dylandibeneditto/bt-lora-transciever/README.md

# bt-lora-transciever

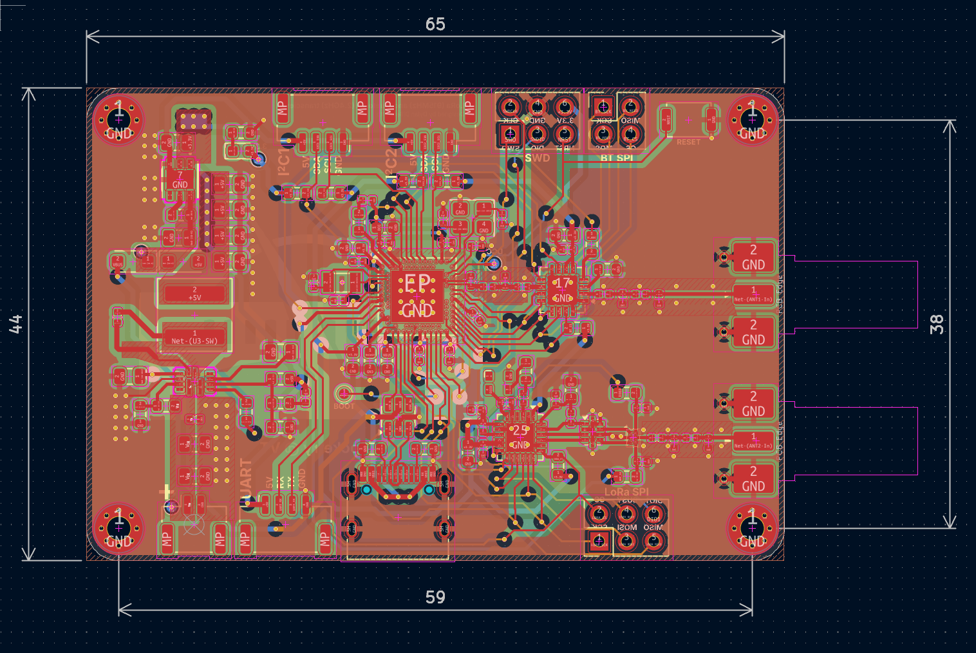
[picture p1: Layout.png]
layout

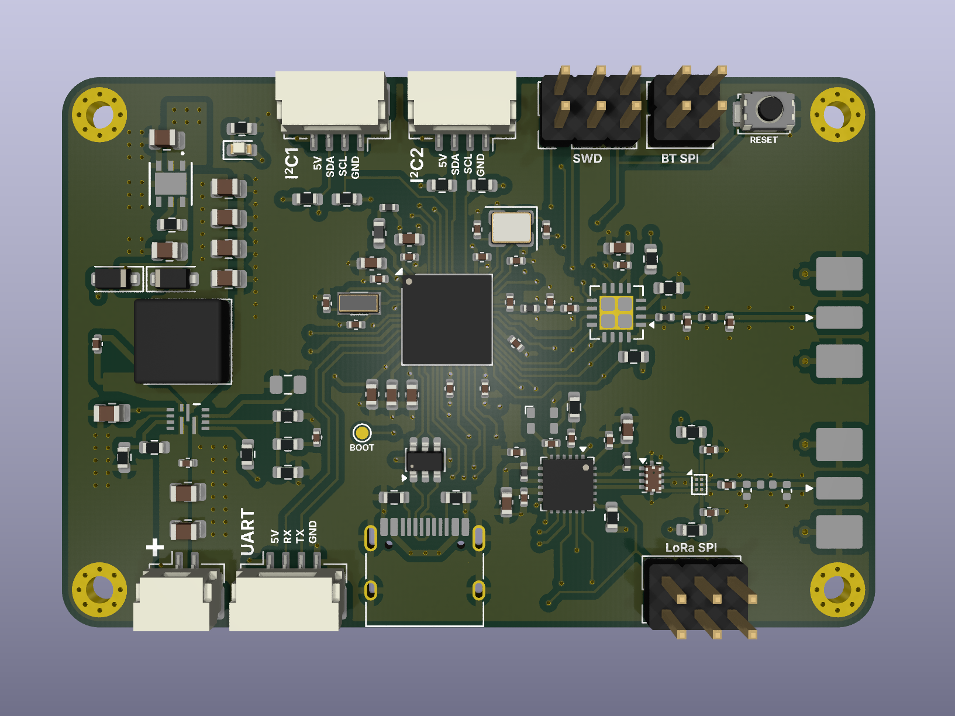
[picture p2: Front_3D.png]
Front 3D

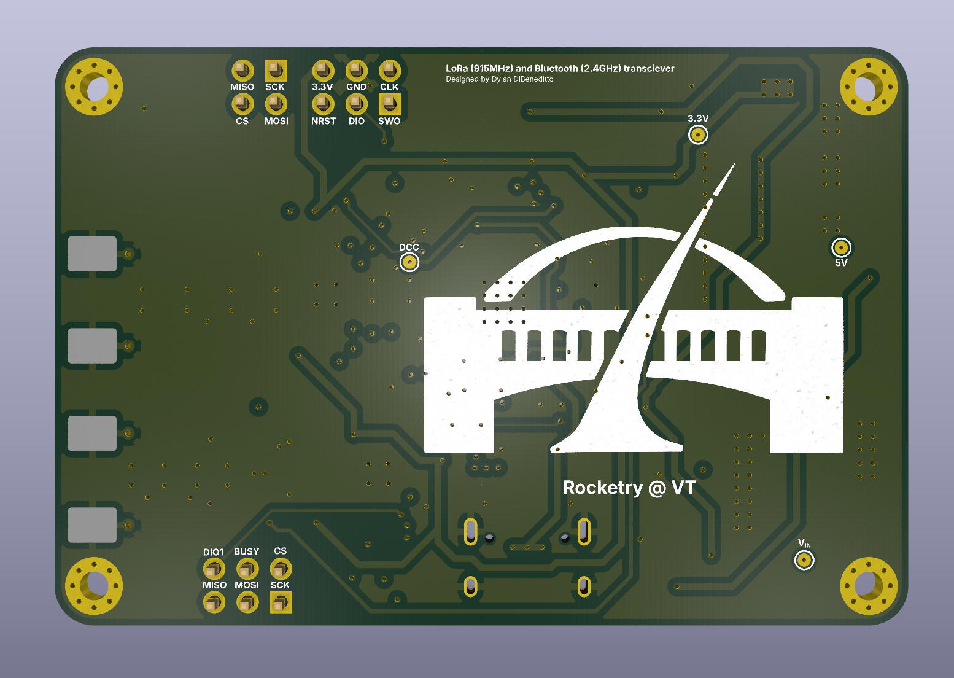
[picture p3: Back_3D.png]
Back 3D


## SX1262 (LoRa)
(datasheet)
https://semtech.my.salesforce.com/sfc/p/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
(application notes)
https://cdn-reichelt.de/documents/datenblatt/A200/SX1262REFERENCE.pdf

## Matching Network IC (0900FM15K0039001E)
https://www.johansontechnology.com/docs/1646/0900FM15K0039001E_rIWs6SY.pdf
https://www.johansontechnology.com/docs/2424/oldjti-an100_kC6DtU1.pdf

## nRF21540 (Bluetooth Range Extender)
https://docs.nordicsemi.com/r/bundle/ps_nrf21540/page/chapters/hw_layout/reference_circuitry/doc/alt1.html

## nRF52840
https://docs.nordicsemi.com/r/bundle/ps_nrf52840/page/keyfeatures_html5.html

## 3.3V LDO (LD39200)
https://www.st.com/content/ccc/resource/technical/document/datasheet/4b/e6/2e/a4/16/04/46/9d/DM00102135.pdf/files/DM00102135.pdf/jcr:content/translations/en.DM001021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

## 5V Buck (TPS51386)
https://www.ti.com/lit/ds/symlink/tps51386.pdf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

## TCXO (ECS-TXO-20SCMV4)
https://ecsxtal.com/store/pdf/ECS-TXO-20CSMV4.pdf
