dylandibeneditto/bt-lora-transciever/Reference Docs/nrf52840_qiaa_config5_schematic_REFERENCE.pdf

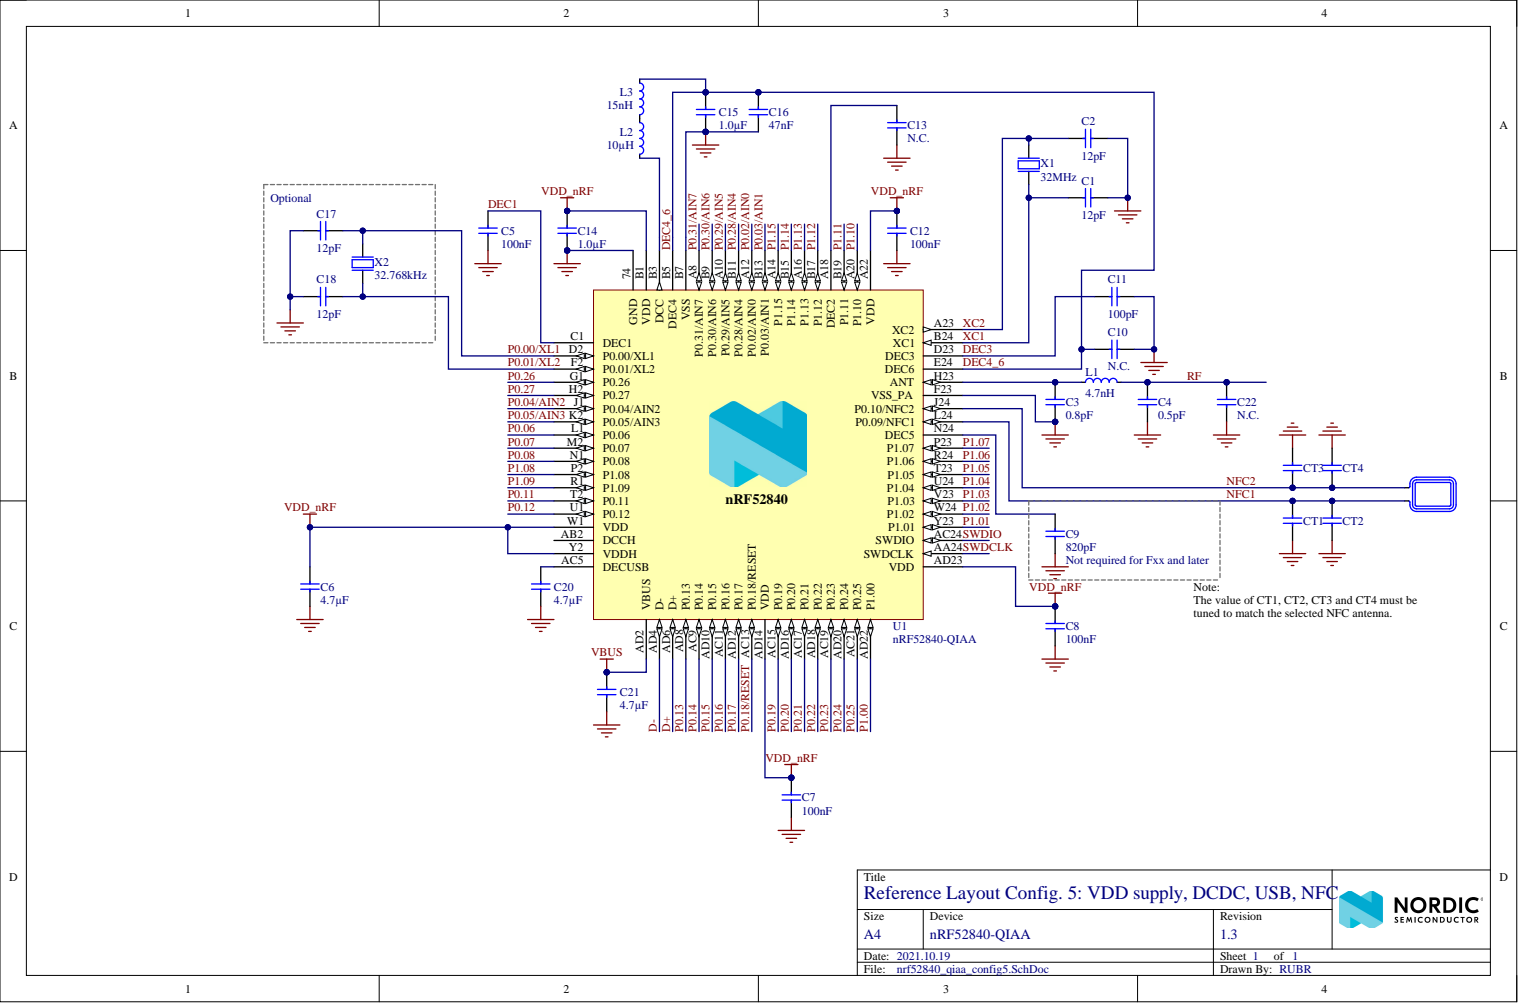
[picture p4: page 1]

Not required for Fxx and later

Note:
The value of CT1, CT2, CT3 and CT4 must be
tuned to match the selected NFC antenna.

Title
Reference Layout Config. 5: VDD supply, DCDC, USB, NFC
