dylandibeneditto/bt-lora-transciever/Reference Docs/nrf21540_EK_Schematic_And_PCB_REFERENCE.pdf

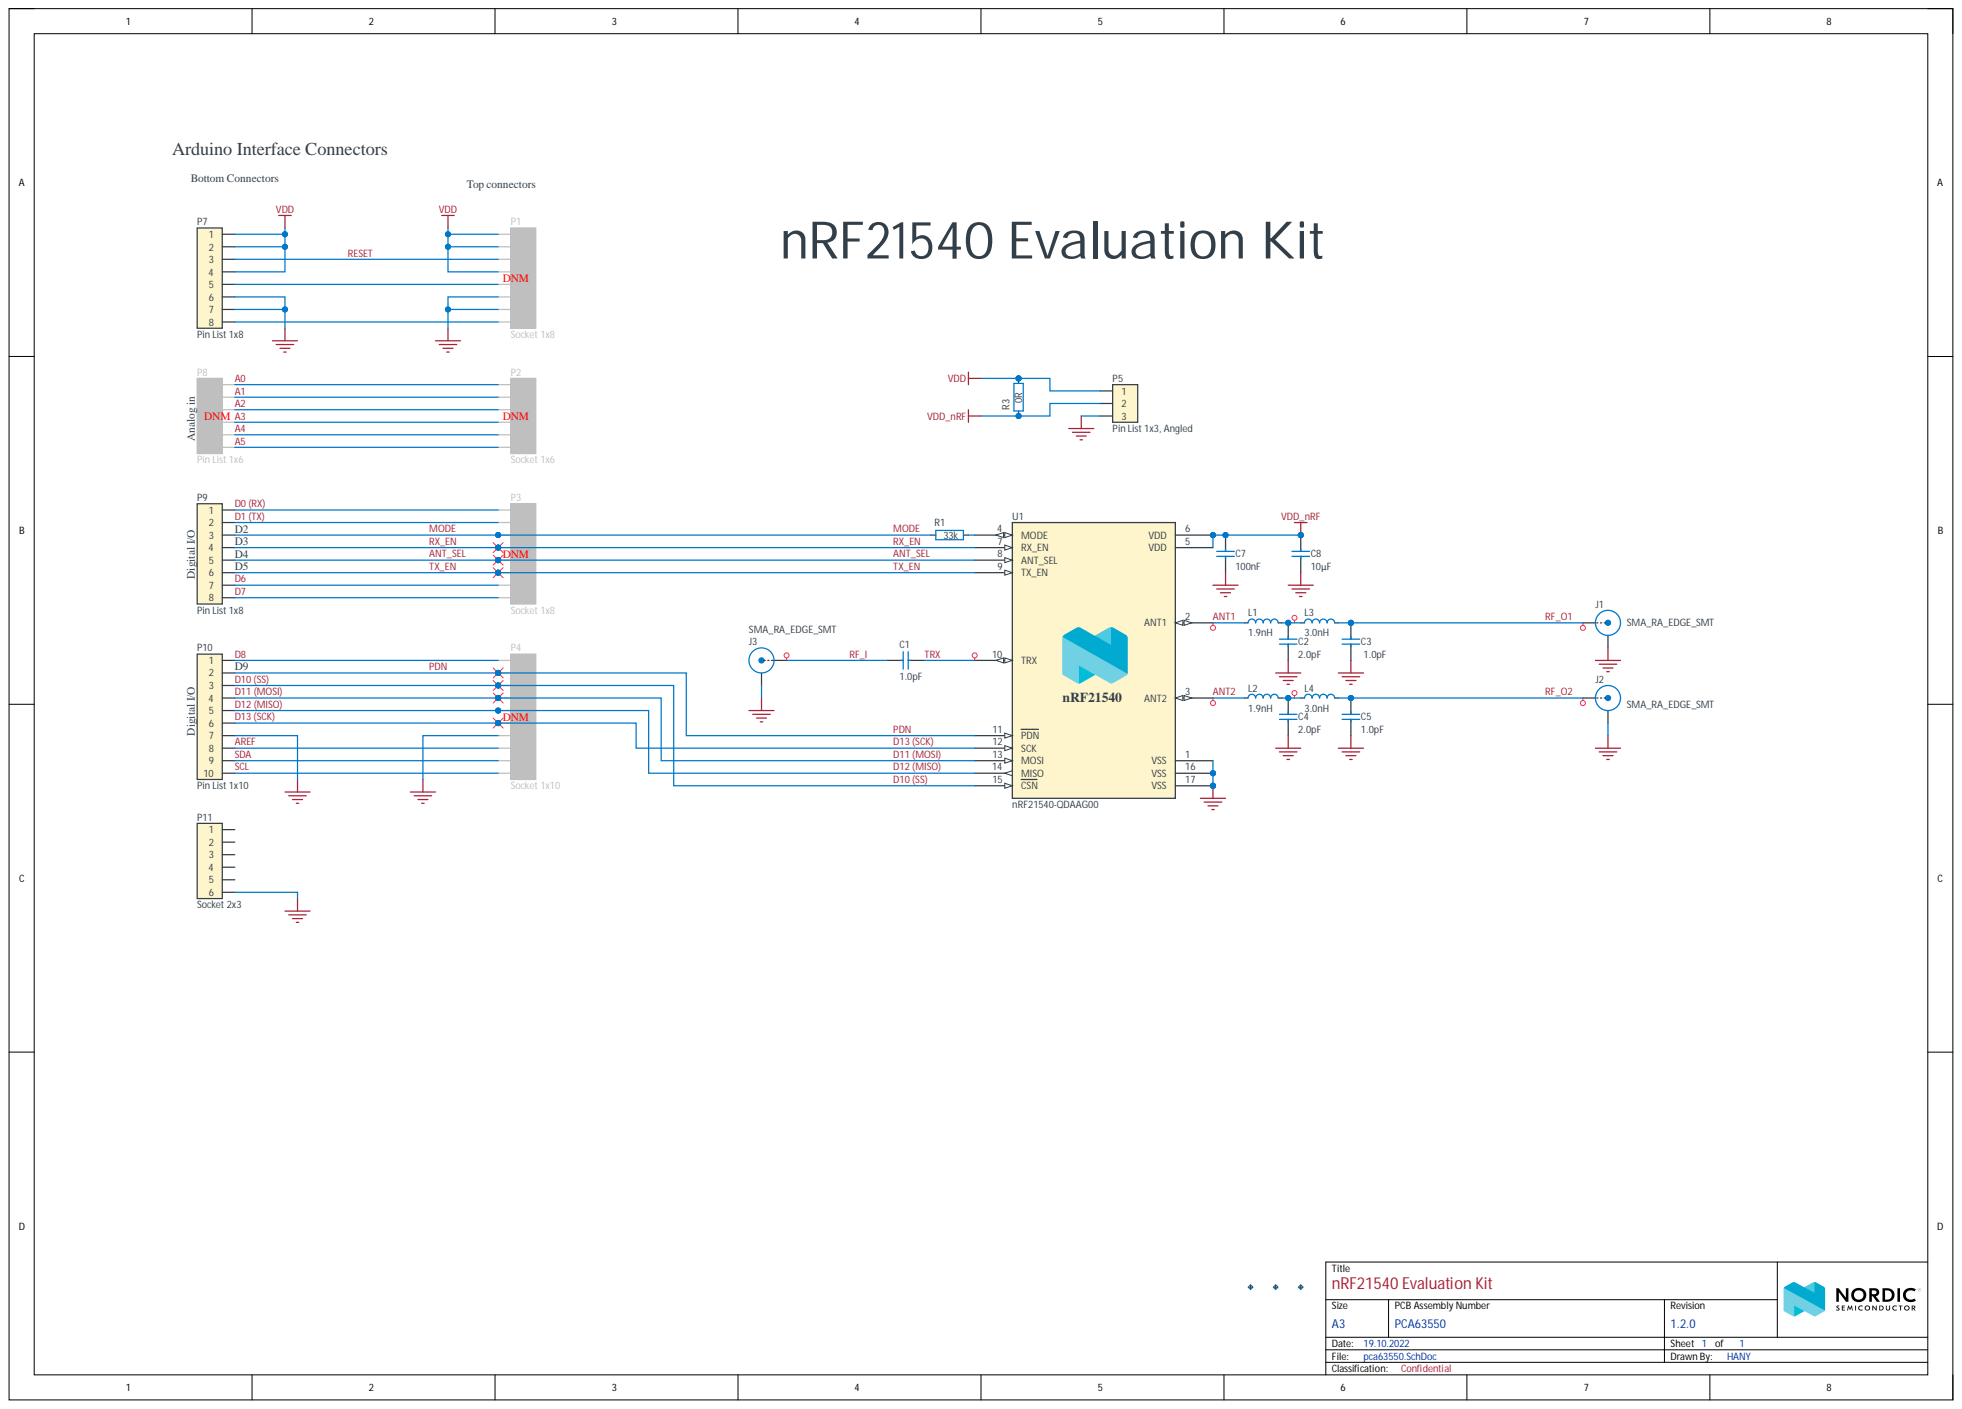
[picture p11: page 1]

Analog in Digital I/O Digital I/O

D4 ANT_SEL DNM | 5 | ANT_SEL | ANT_SEL 8
D5 TX_EN | 6 | TX_EN | TX_EN 9
D6 | 7 8 | | TRX 10

D10 (SS) | 3 | | 1.0pF
D11 (MOSI) | 4
D12 (MISO) | 5
D13 (SCK) DNM | 6
AREF | | | | 7 8 | D13 (SCK) | SCK 12
SDA | | | | 9 | D11 (MOSI) | MOSI 13

PDN

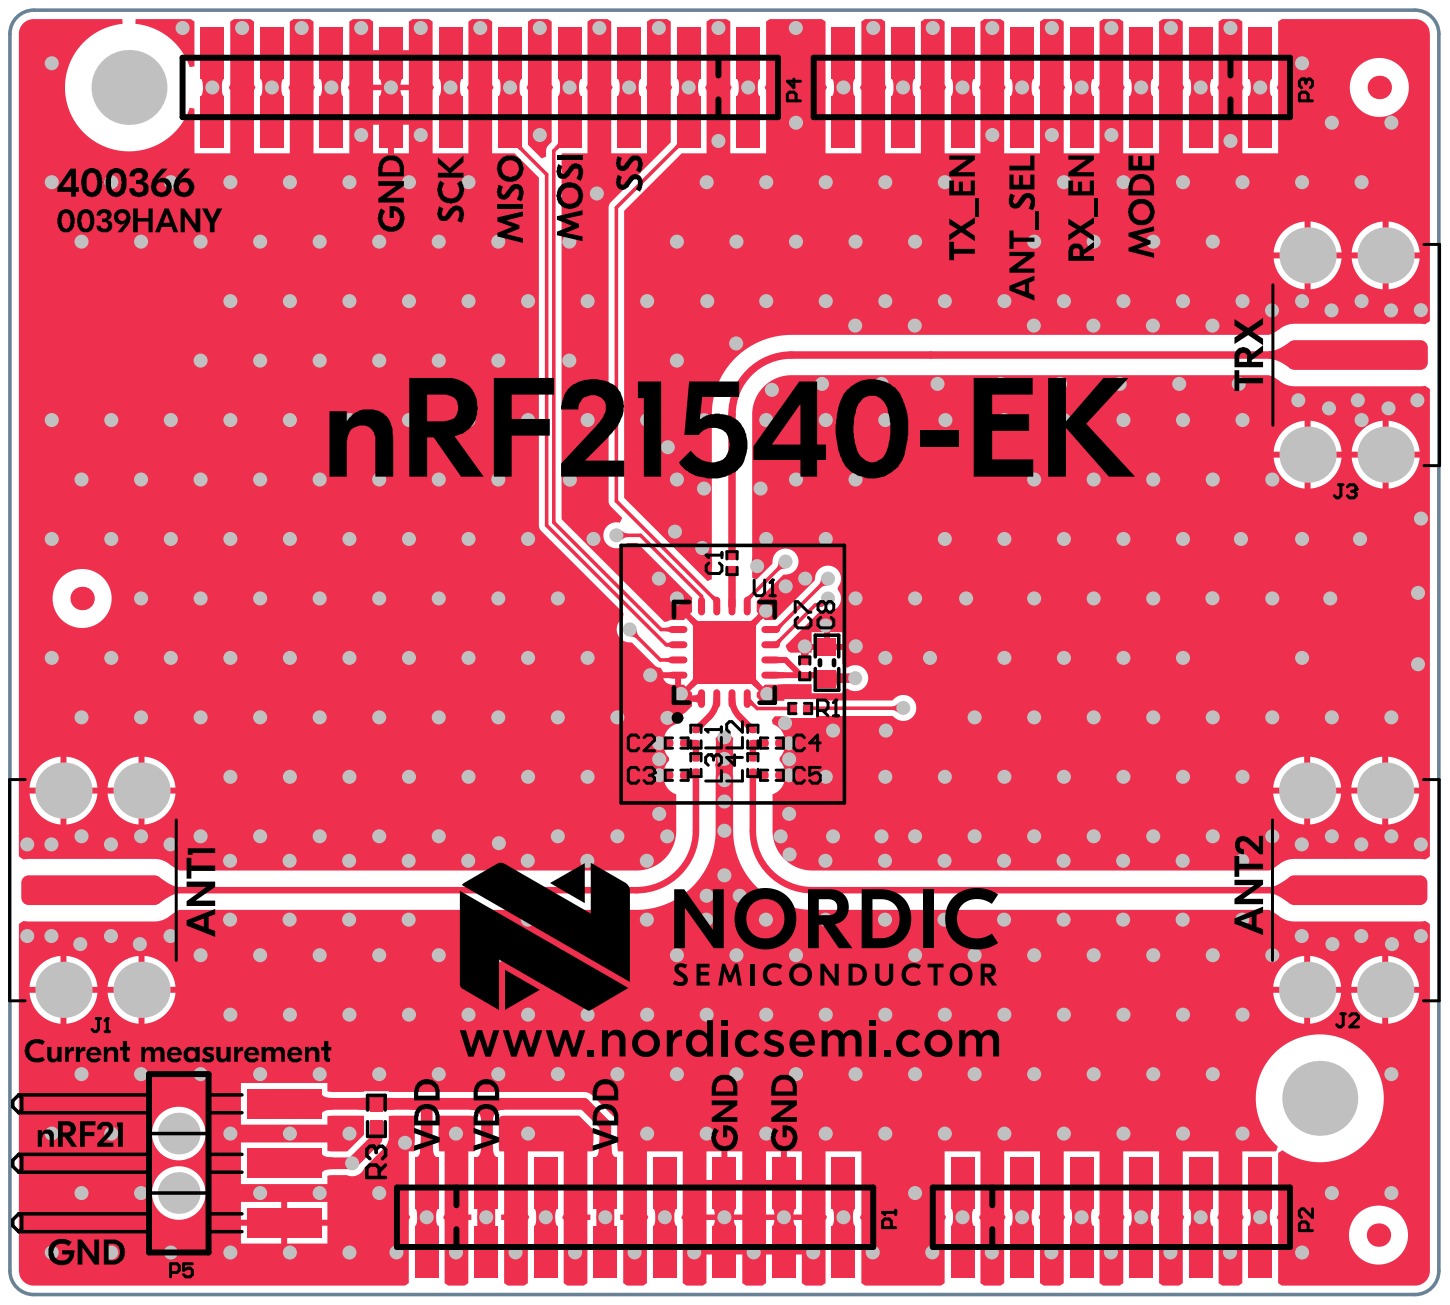
[picture p12: page 2]

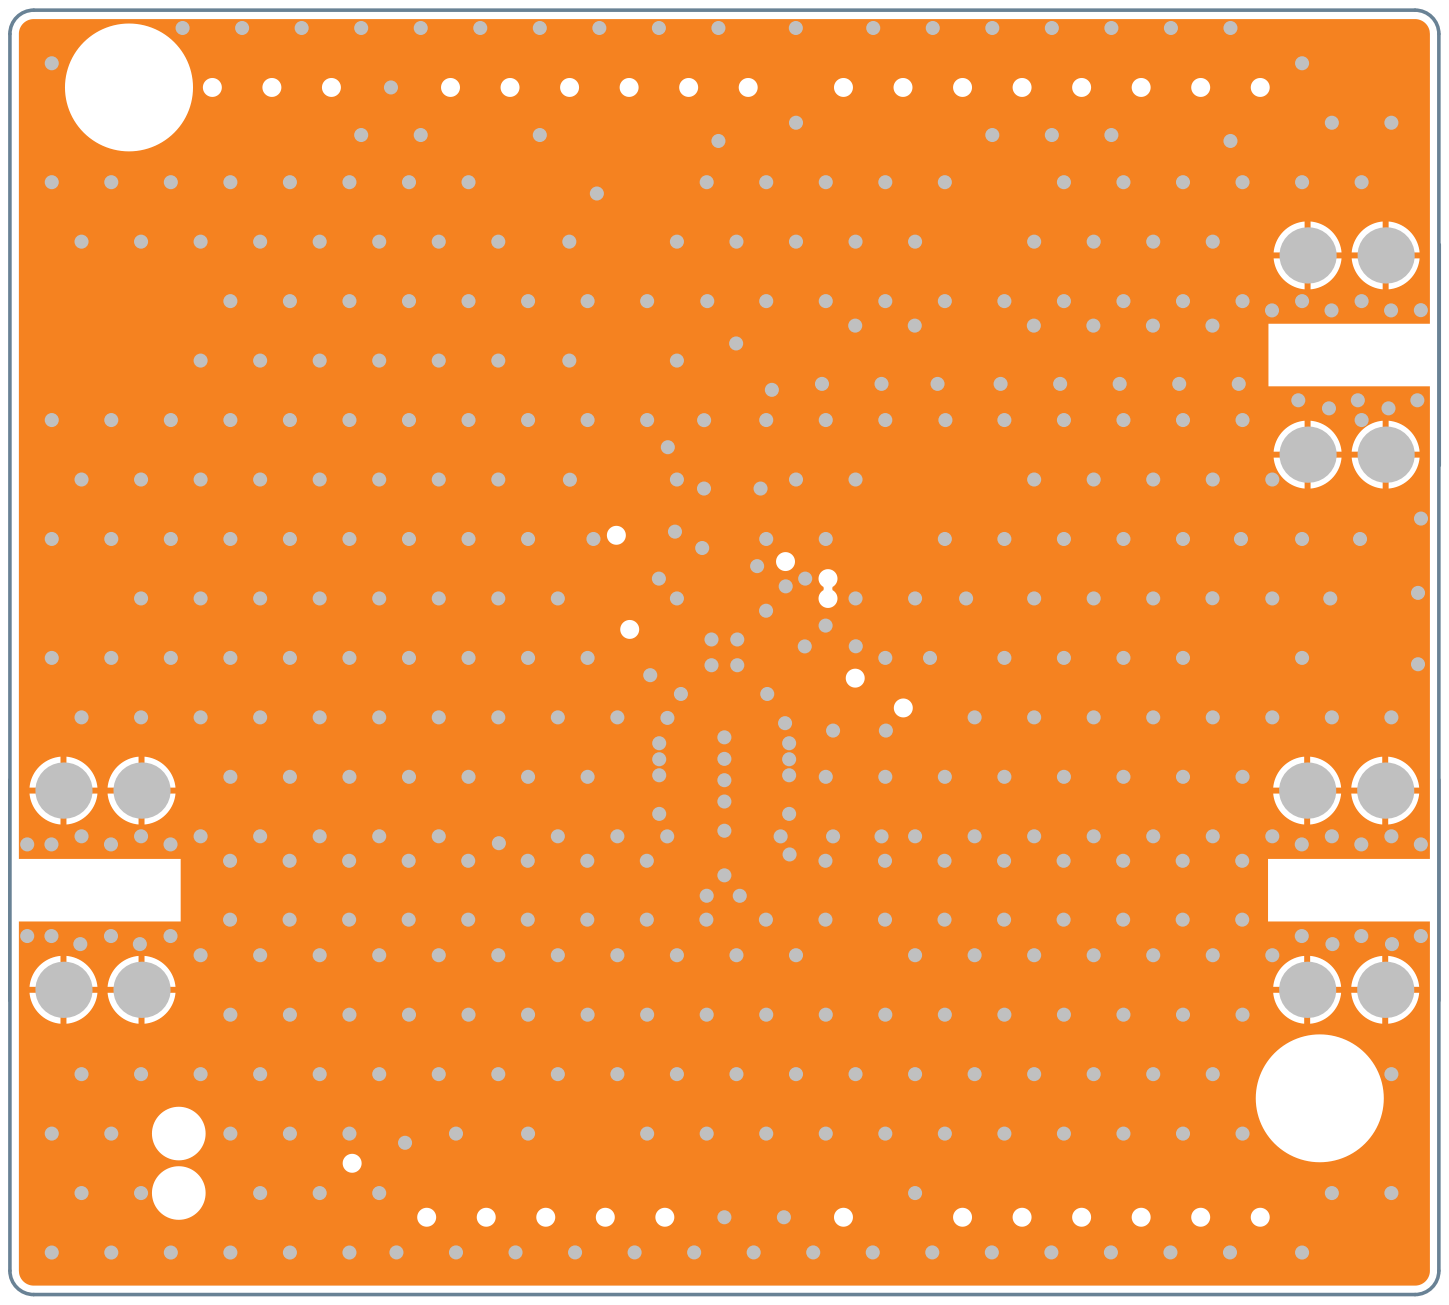
[picture p13: page 3]

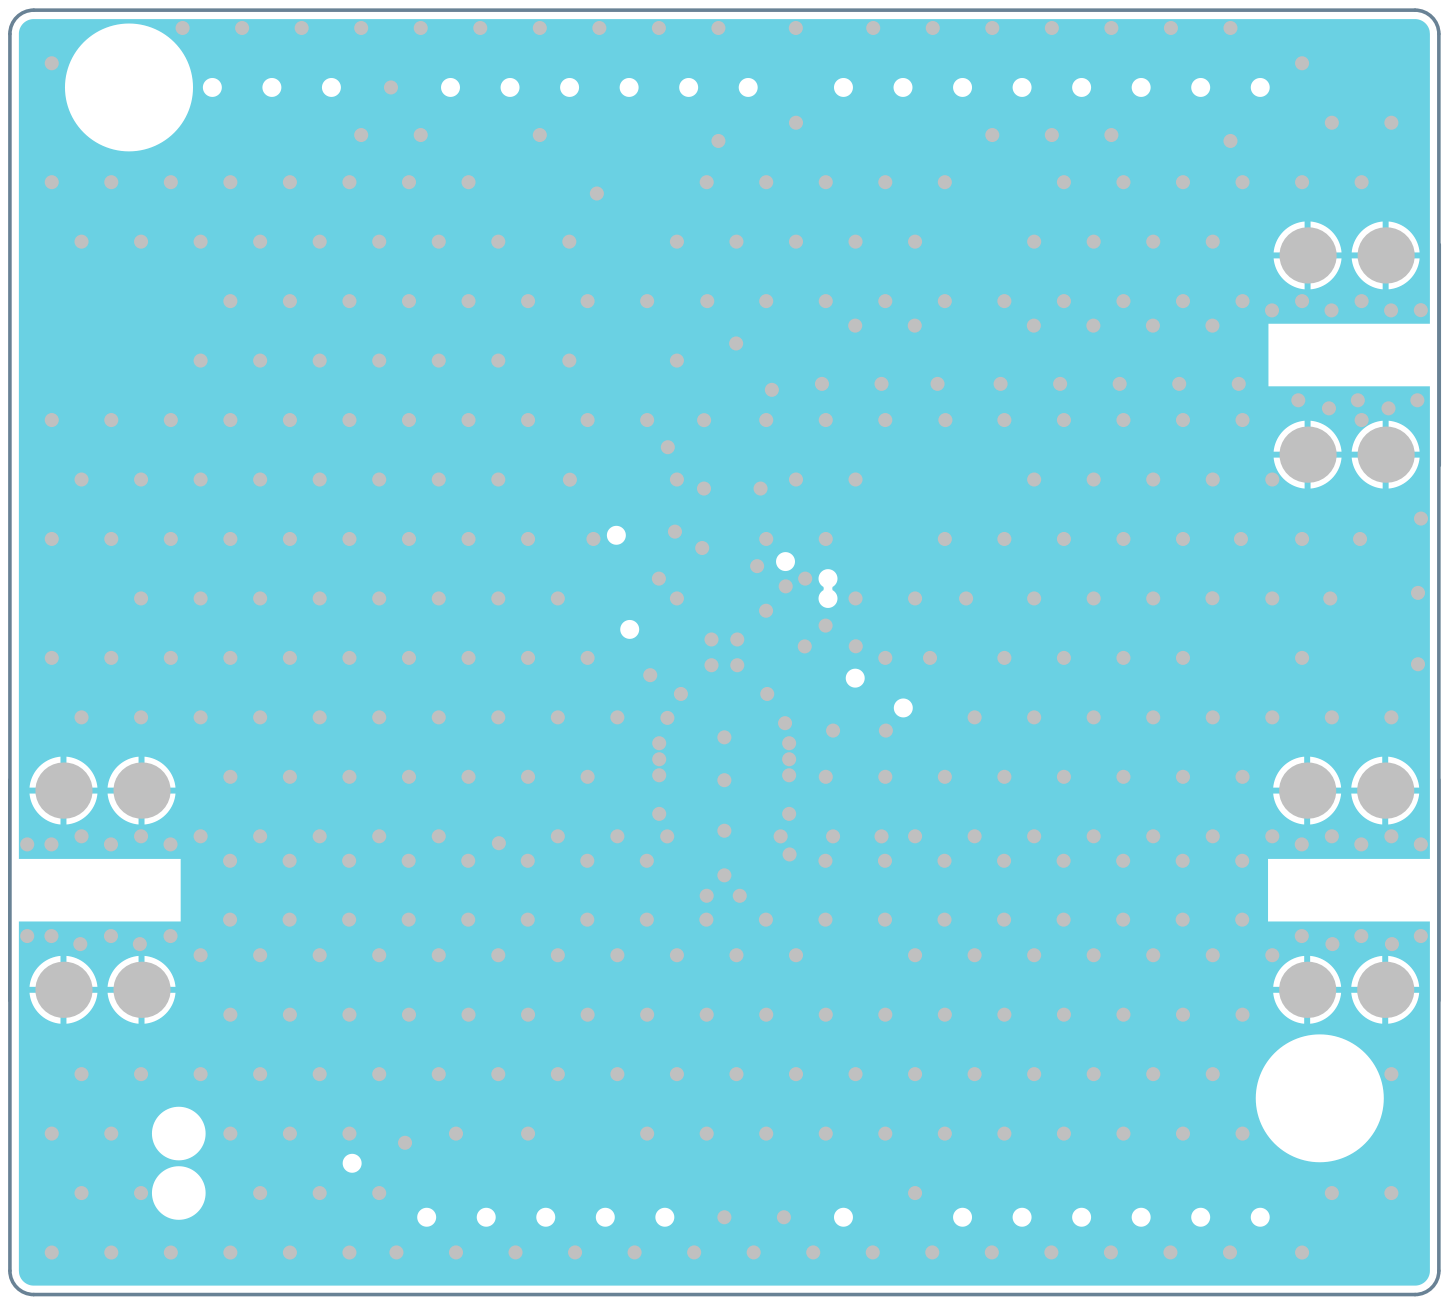
[picture p14: page 4]

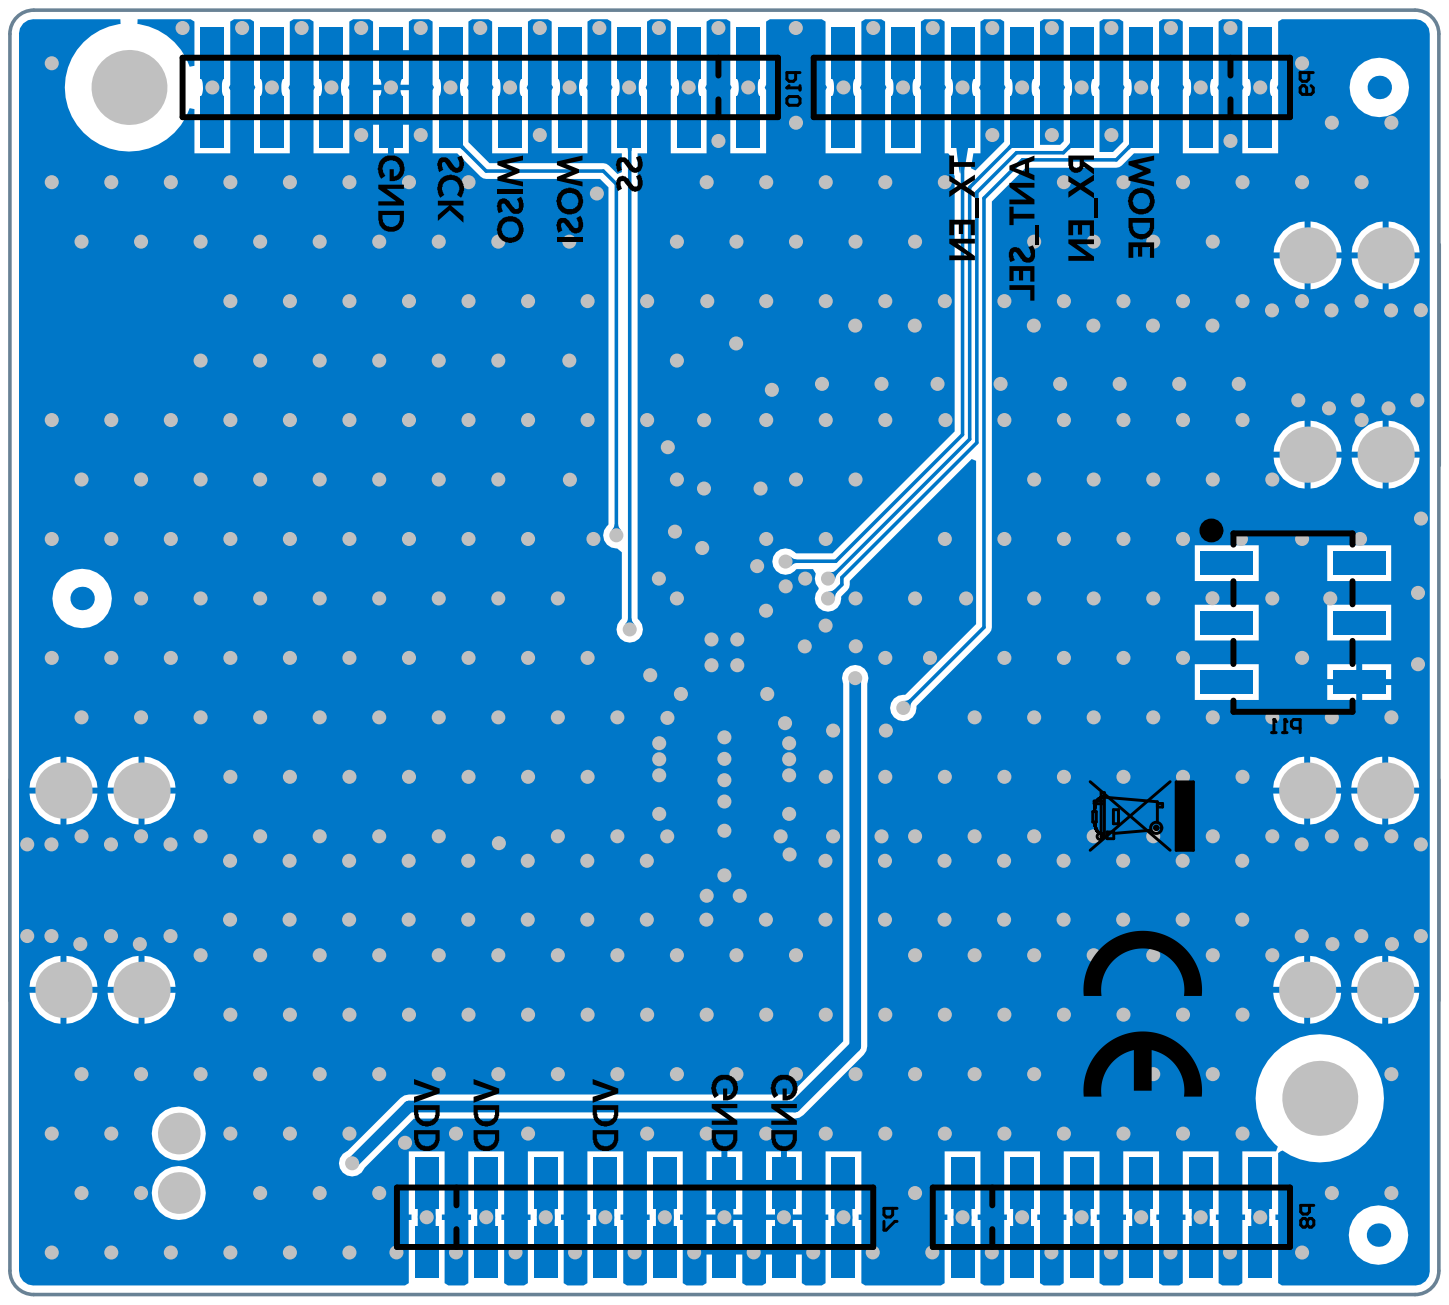
[picture p15: page 5]

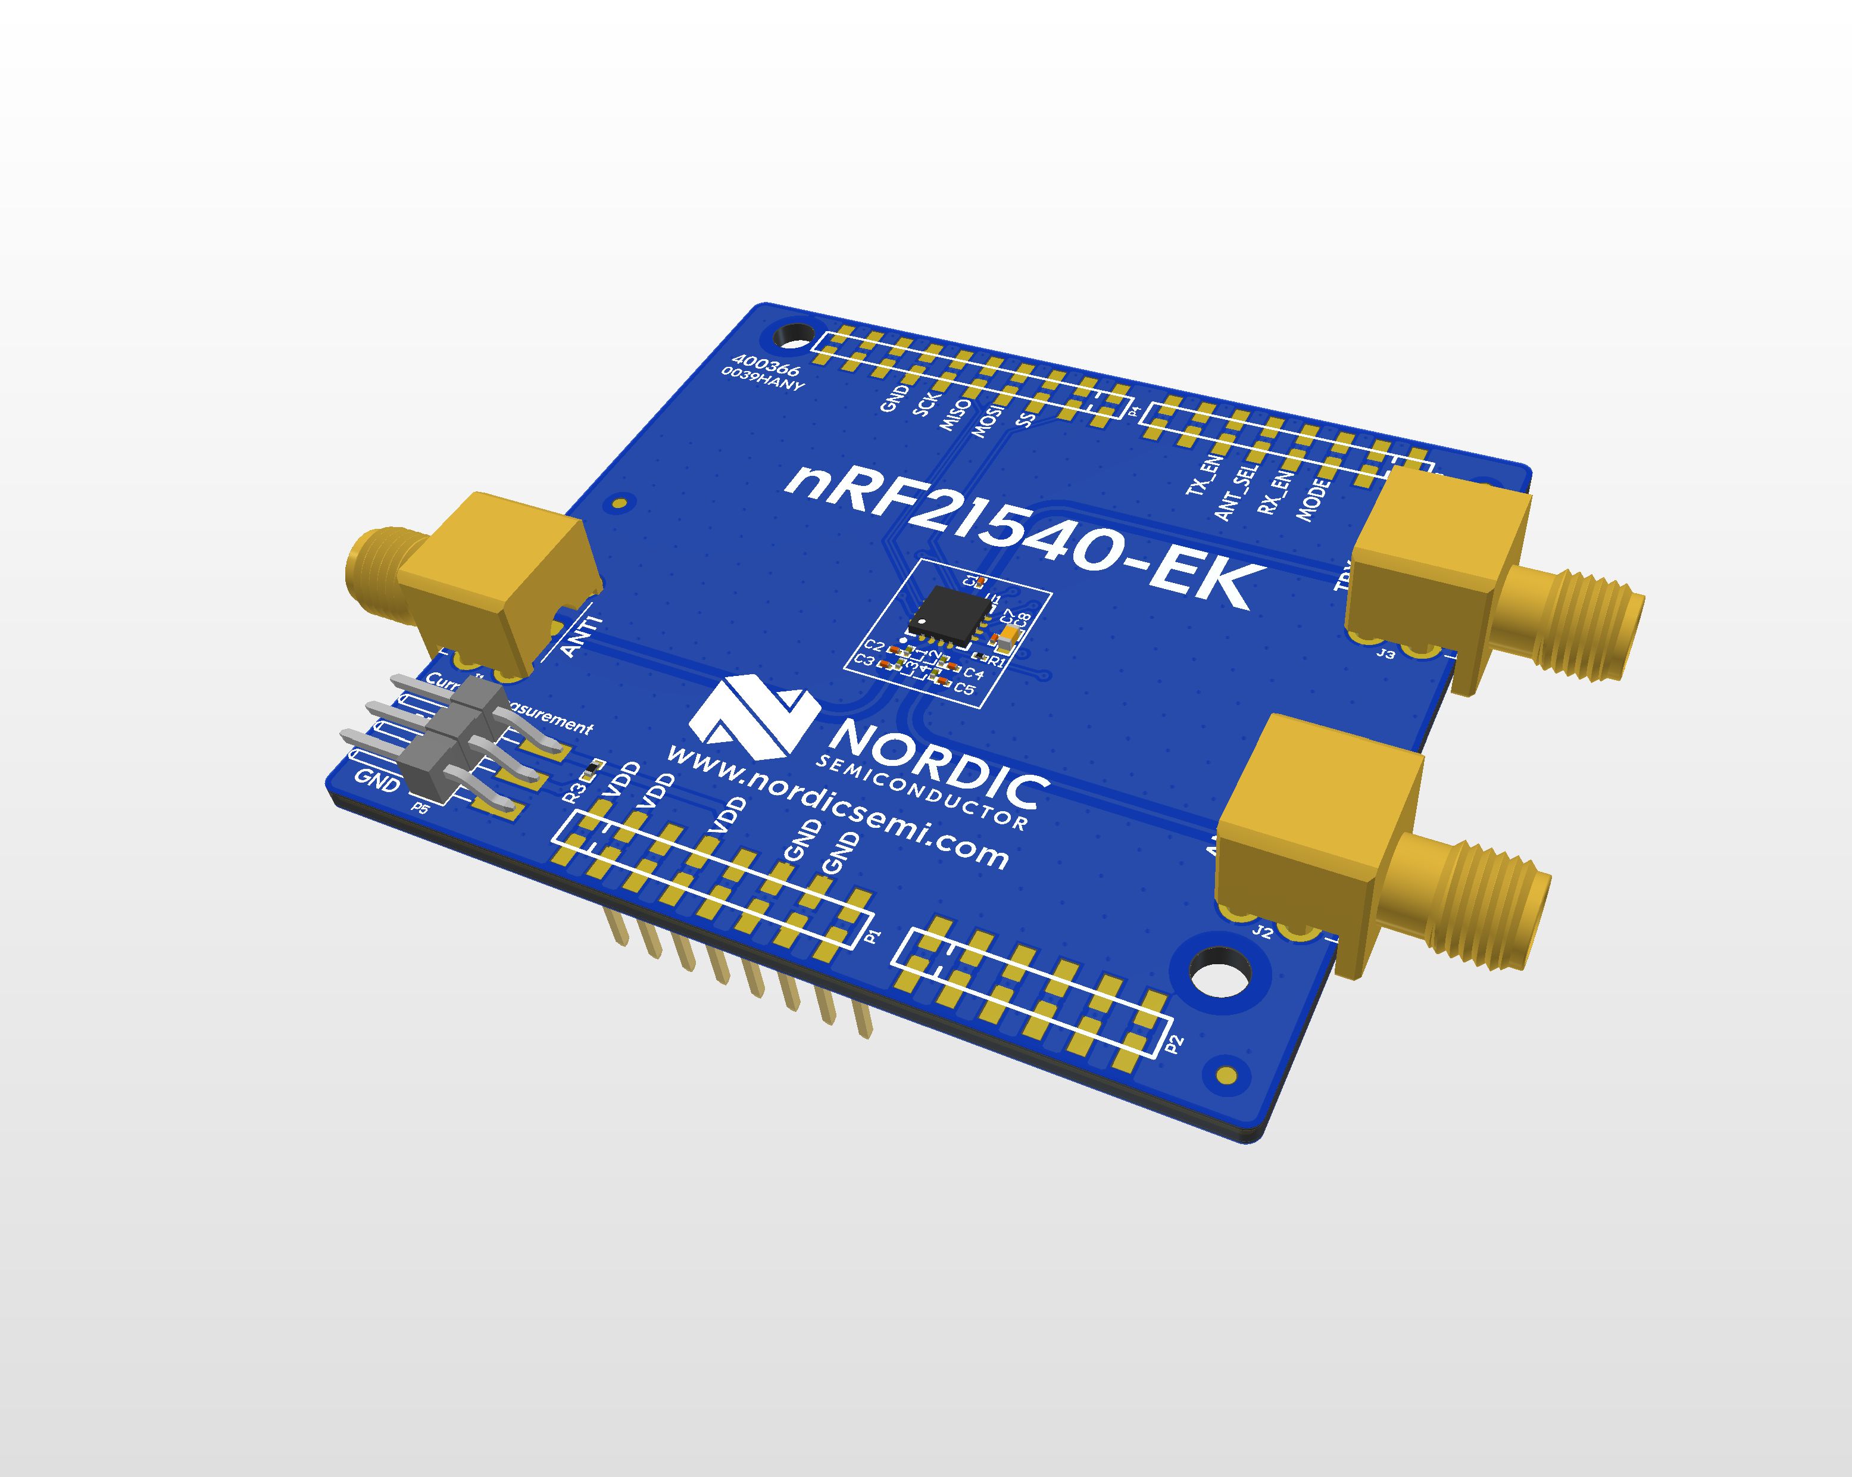
[picture p16: page 6]
