dylandibeneditto/bt-lora-transciever/Reference Docs/nrf52840_qiaa_config5_pcb_REFERENCE.pdf

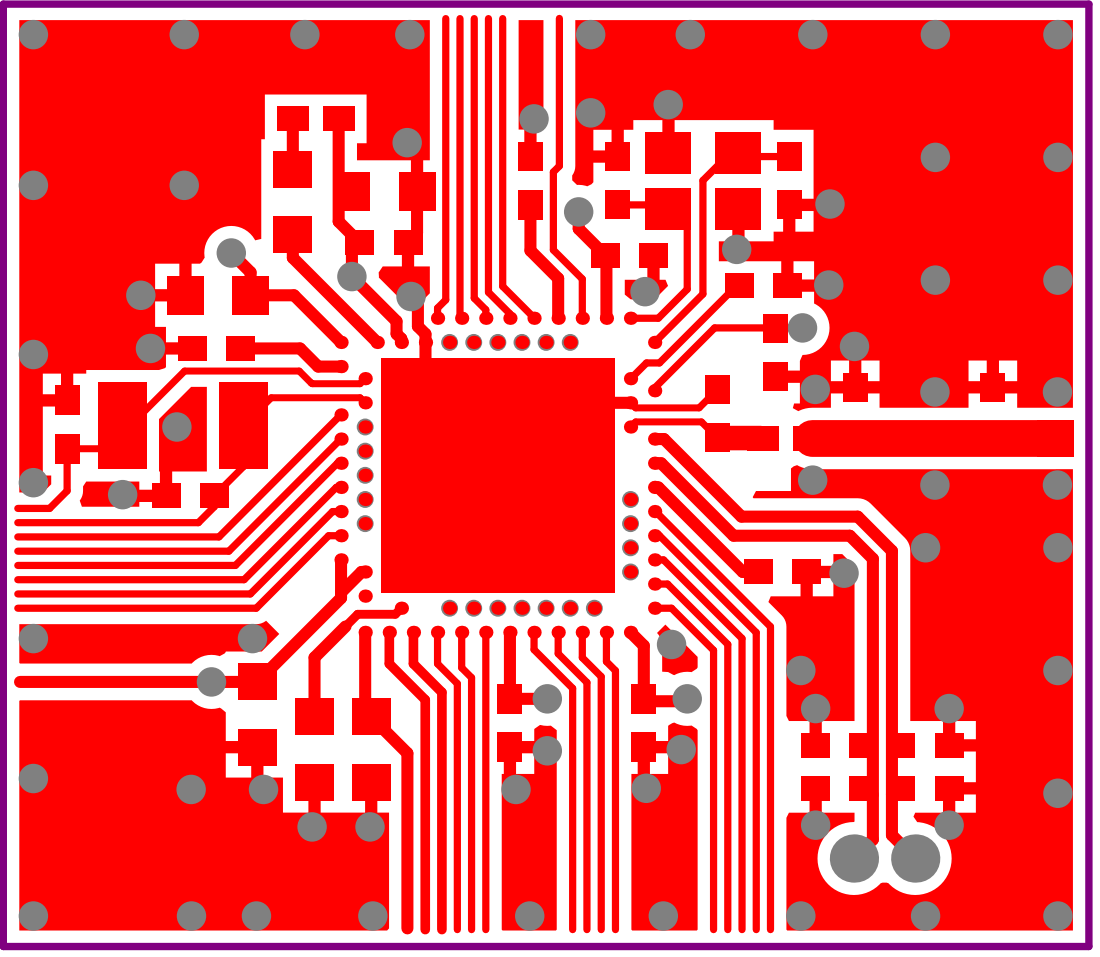
[picture p17: page 1]

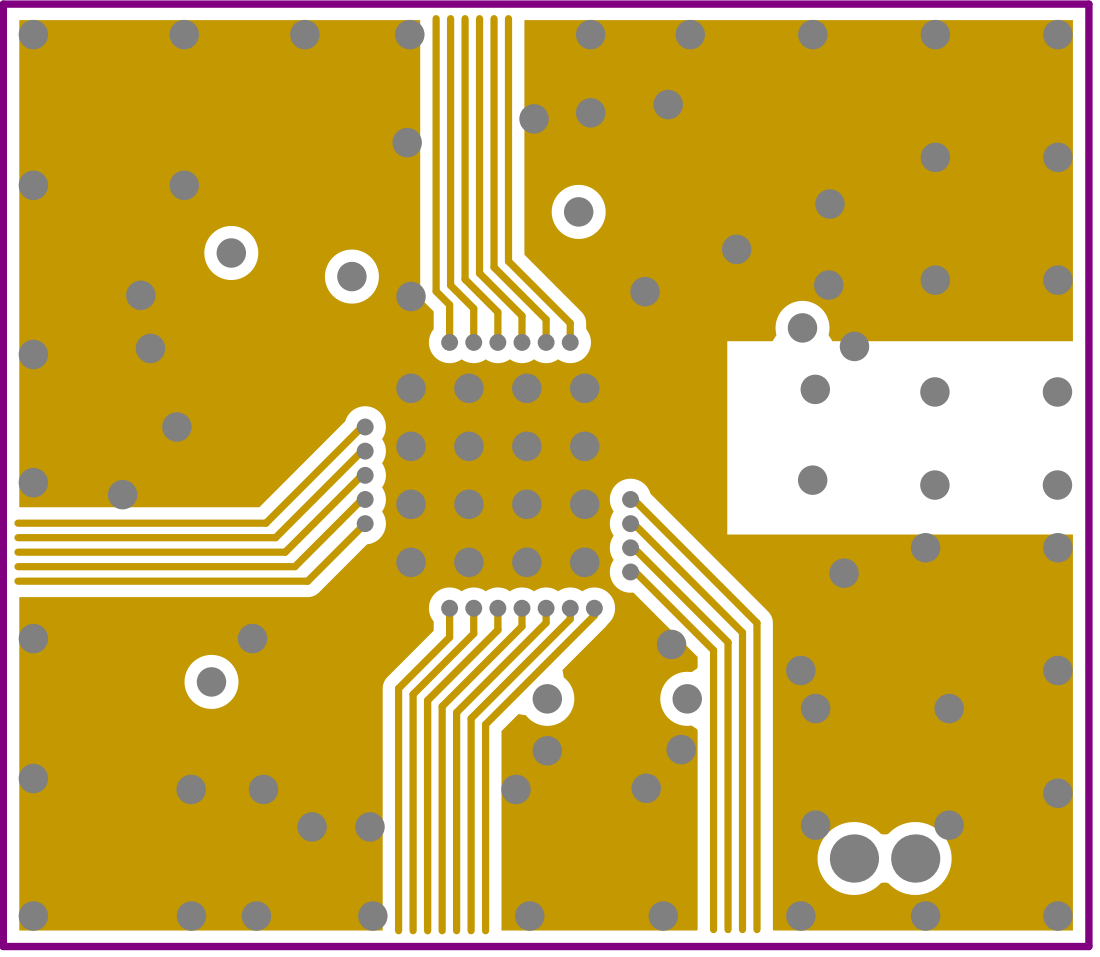
[picture p18: page 2]

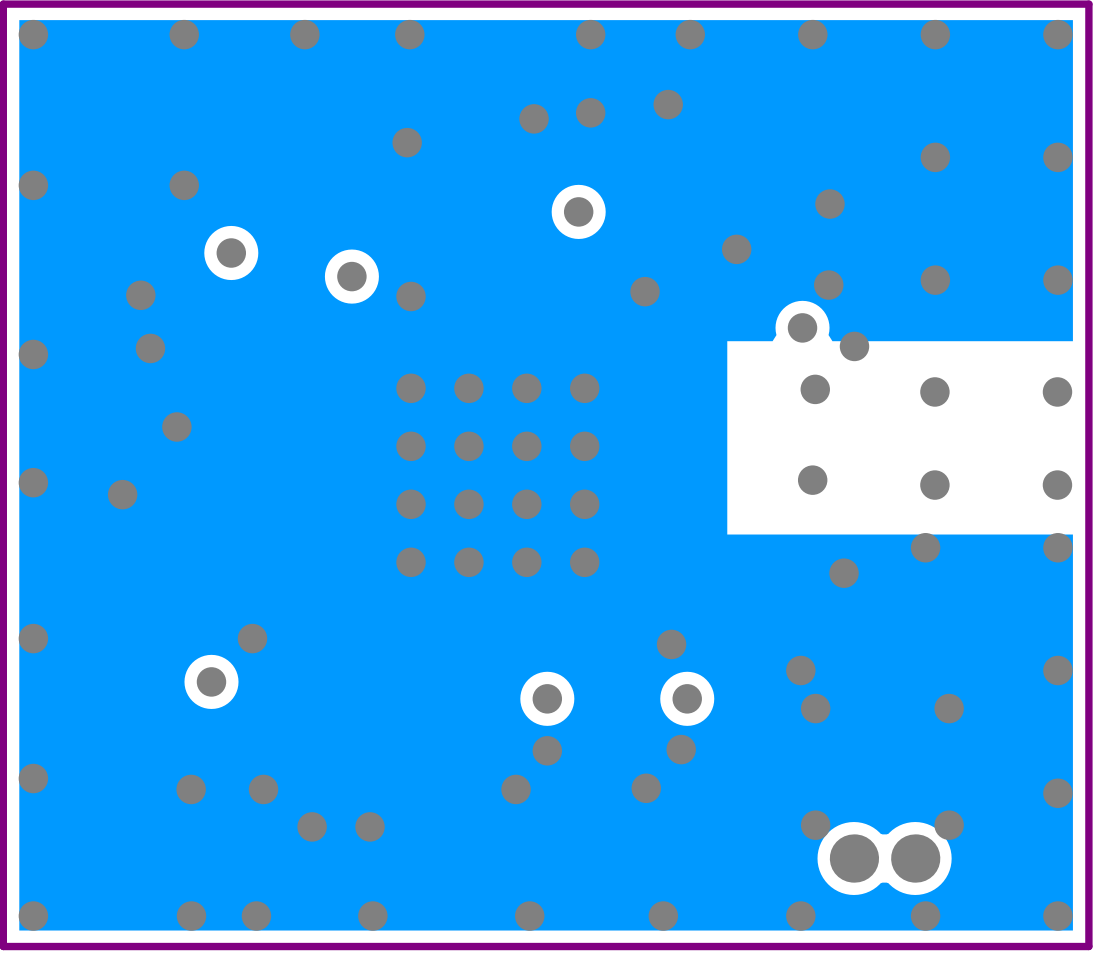
[picture p19: page 3]

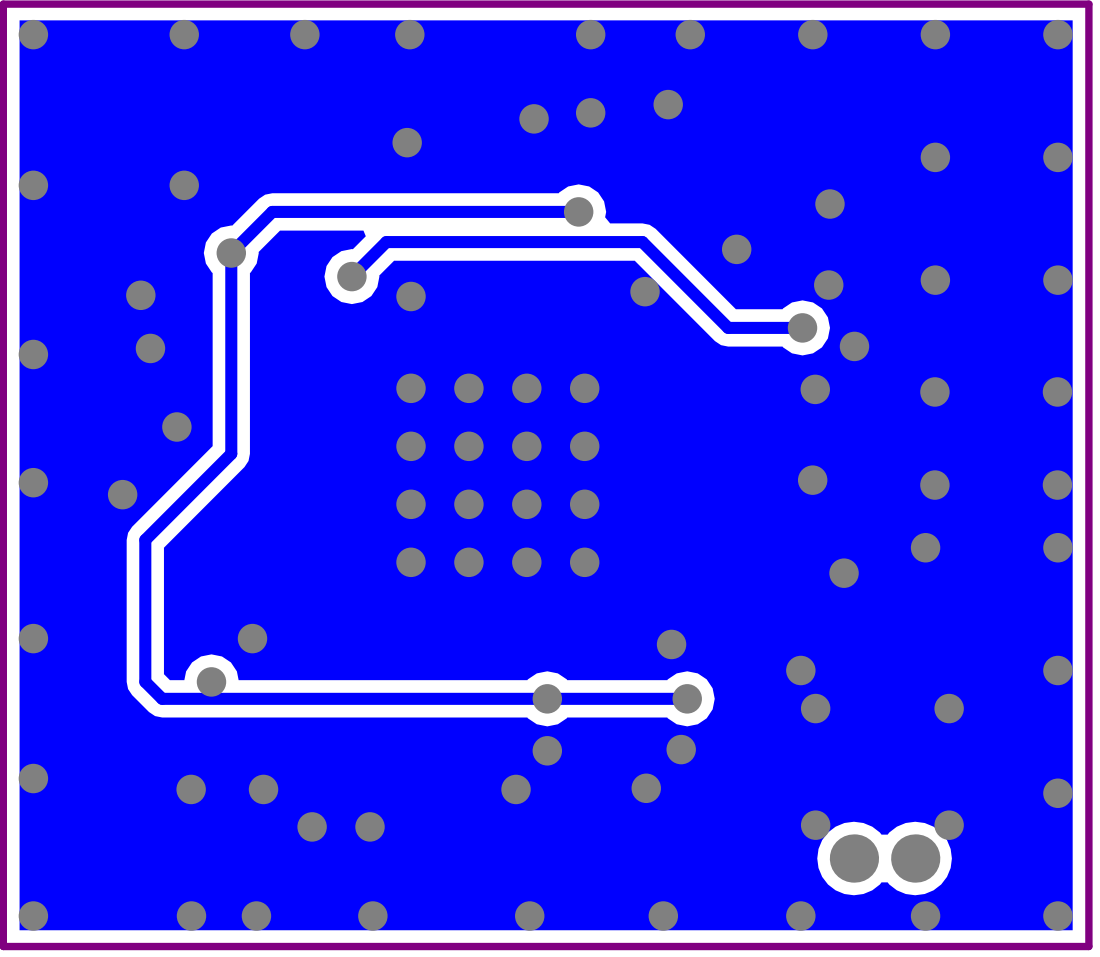
[picture p20: page 4]

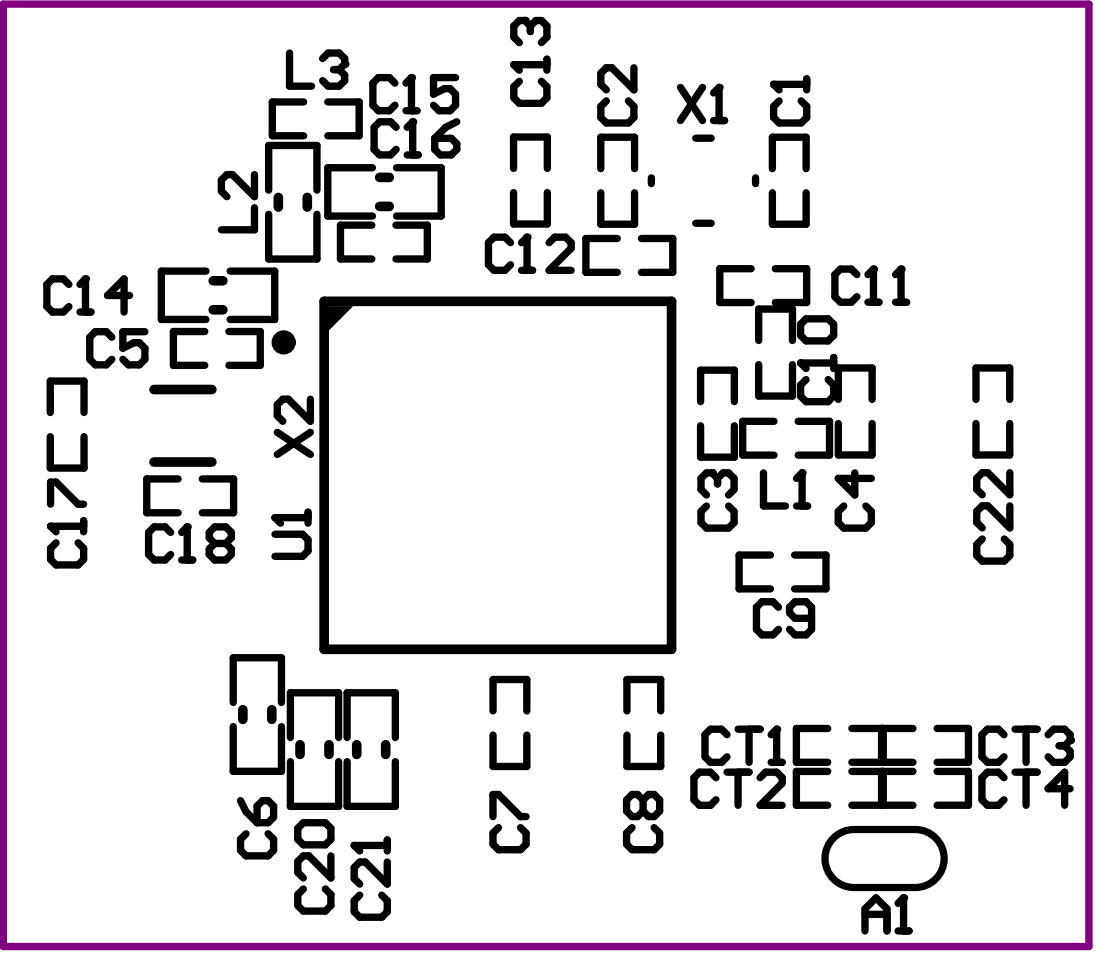
[picture p21: page 5]
