dylandibeneditto/bt-lora-transciever/pcb/pcb.kicad_pcb

## KiCad design pcb/pcb.kicad_pcb (2026-10-24)

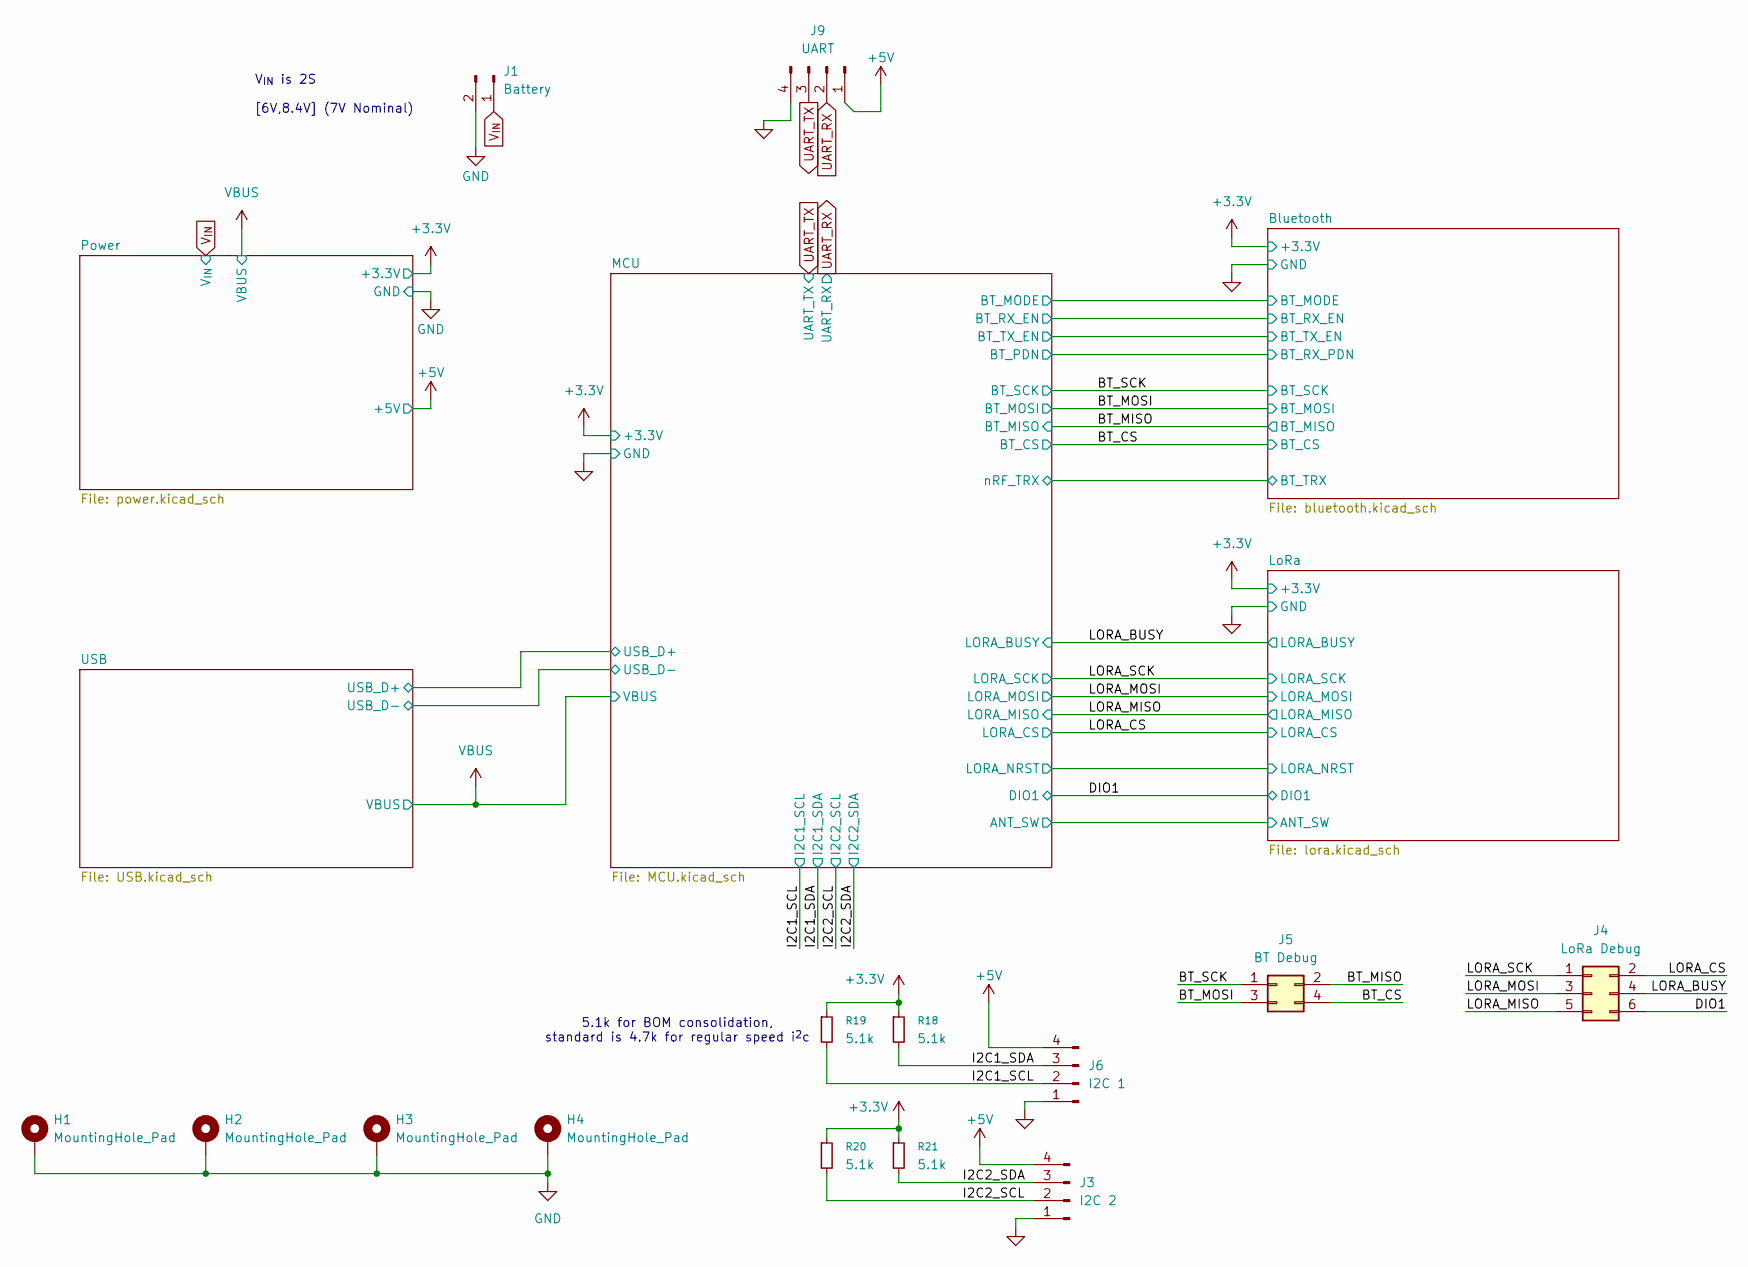
[picture p22: schematic pcb.kicad_sch, 2.4GHz BT and 915MHz LoRa Transciever]

Parts:
H1, H2, H3, H4: MountingHole_Pad; MountingHole_2.2mm_M2_Pad_Via
J1: Battery; JST_GH_SM02B-GHS-TB_1x02-1MP_P1.25mm_Horizontal
J3: I2C 2; JST_GH_SM04B-GHS-TB_1x04-1MP_P1.25mm_Horizontal
J4: LoRa Debug; PinHeader_2x03_P2.54mm_Vertical
J5: BT Debug; PinHeader_2x02_P2.54mm_Vertical
J6: I2C 1; JST_GH_SM04B-GHS-TB_1x04-1MP_P1.25mm_Horizontal
J9: UART; JST_GH_SM04B-GHS-TB_1x04-1MP_P1.25mm_Horizontal
R18, R19, R20, R21: 5.1k; R_0603_1608Metric

Connections:
+3.3V: R18.1, R19.1, R20.1, R21.1; also elsewhere on the board
+5V: J3.4, J6.4, J9.1; also elsewhere on the board
BT_CS: J5.4; also elsewhere on the board
BT_MISO: J5.2; also elsewhere on the board
BT_MOSI: J5.3; also elsewhere on the board
BT_SCK: J5.1; also elsewhere on the board
DIO1: J4.6; also elsewhere on the board
GND: H1.1 (1_1), H2.1 (1_1), H3.1 (1_1), H4.1 (1_1), J1.2, J3.1, J6.1, J9.4; also elsewhere on the board
I2C1_SCL: J6.2, R19.2; also elsewhere on the board
I2C1_SDA: J6.3, R18.2; also elsewhere on the board
I2C2_SCL: J3.2, R20.2; also elsewhere on the board
I2C2_SDA: J3.3, R21.2; also elsewhere on the board
LORA_BUSY: J4.4; also elsewhere on the board
LORA_CS: J4.2; also elsewhere on the board
LORA_MISO: J4.5; also elsewhere on the board
LORA_MOSI: J4.3; also elsewhere on the board
LORA_SCK: J4.1; also elsewhere on the board
UART_RX: J9.2; also elsewhere on the board
UART_TX: J9.3; also elsewhere on the board
V_{IN}: J1.1; also elsewhere on the board

Notes on the sheet:
V_{IN} is 2S [6V,8.4V] (7V Nominal)
5.1k for BOM consolidation, standard is 4.7k for regular speed i^{2}c

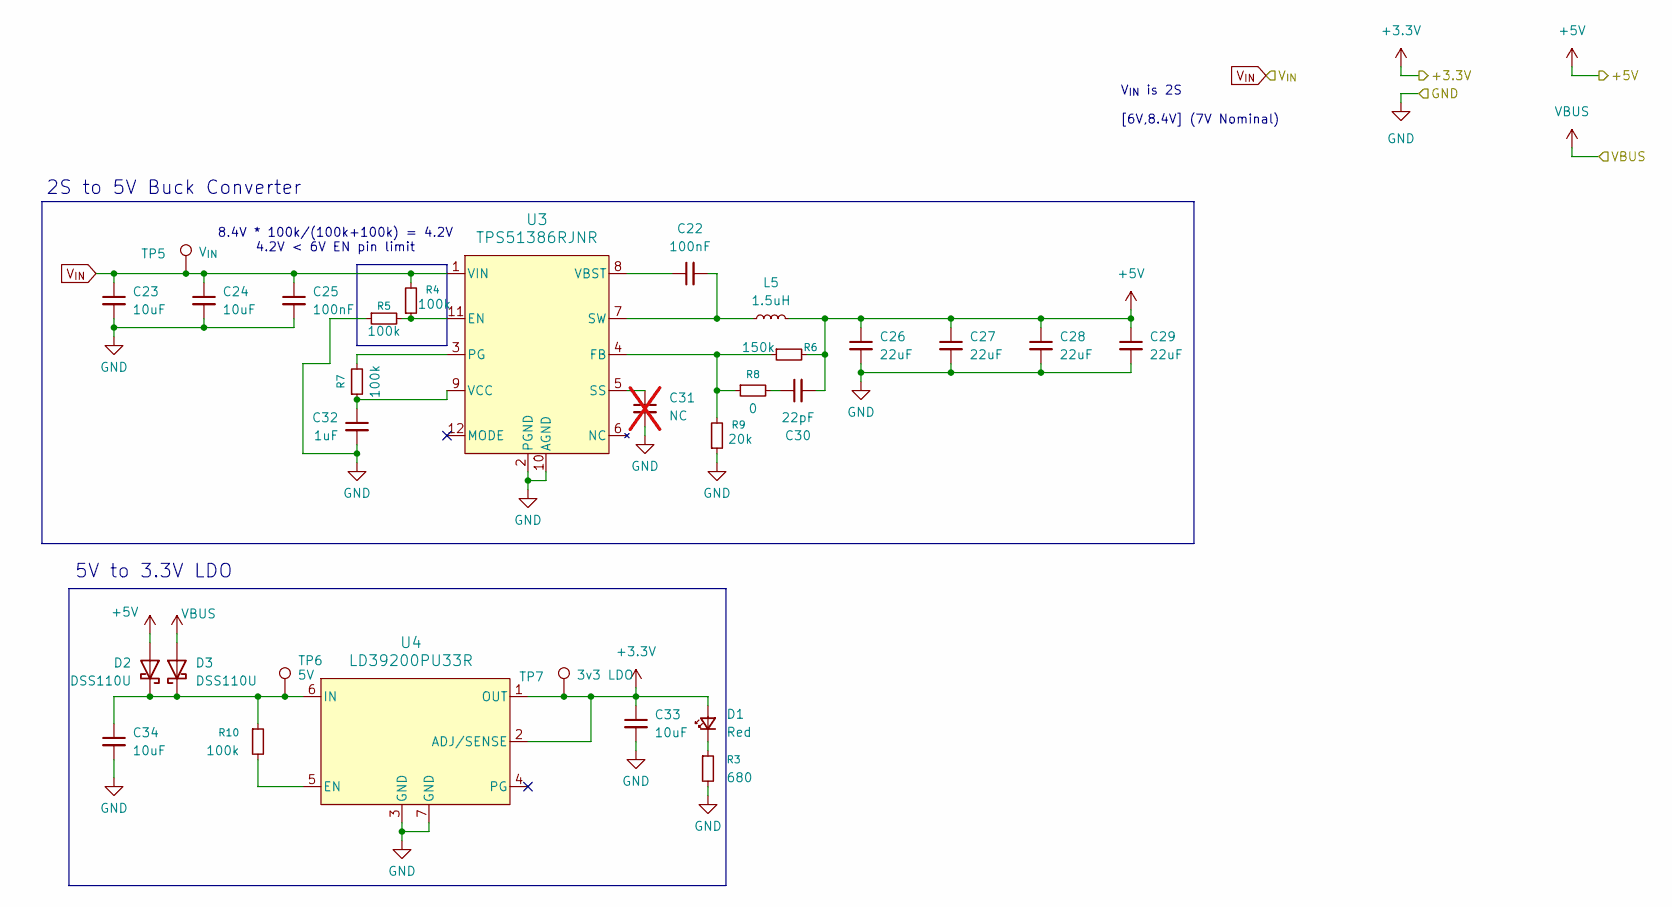
[picture p23: schematic power.kicad_sch]

Parts:
C22, C25: 100nF; C_0402_1005Metric
C23, C24, C33, C34: 10uF; C_0805_2012Metric
C26, C27, C28, C29: 22uF; C_0805_2012Metric
C30: 22pF; C_0402_1005Metric
C31: NC; C_0805_2012Metric; not fitted
C32: 1uF; C_0805_2012Metric
D1: Red; LED_0603_1608Metric
D2, D3: DSS110U; D_SOD-123F
L5: 1.5uH; L_Coilcraft_XAL6030-XXX
R3: 680; R_0603_1608Metric
R4, R5, R7, R10: 100k; R_0603_1608Metric
R6: 150k; R_0603_1608Metric
R8: 0; R_0603_1608Metric
R9: 20k; R_0603_1608Metric
TP5: V_{IN}; TestPoint_Pad_D1.0mm
TP6: 5V; TestPoint_Pad_D1.0mm
TP7: 3v3 LDO; TestPoint_Pad_D1.0mm
U3: TPS51386RJNR; VQFN-HR12_RJN_TEX
U4: LD39200PU33R; SON_DFN6_3X3_STM

Connections:
+3.3V: C33.1, D1.2 (A), TP7.1 (1_1), U4.1 (OUT), U4.2 (ADJ/SENSE); also elsewhere on the board
+5V: C26.1, C27.1, C28.1, C29.1, C30.2, D2.2 (A), L5.2, R6.2; also elsewhere on the board
GND: C23.2, C24.2, C25.2, C26.2, C27.2, C28.2, C29.2, C31.2, C32.2, C33.2, C34.2, R3.2, R5.1, R9.1, U3.2 (PGND), U3.10 (AGND), U4.3 (GND), U4.7 (GND); also elsewhere on the board
unnamed: C30.1, R8.2
unnamed: D1.1 (K), R3.1
unnamed: C34.1, D2.1 (K), D3.1 (K), R10.1, TP6.1 (1_1), U4.6 (IN)
unnamed: R4.1, R5.2, U3.11 (EN)
unnamed: R6.1, R8.1, R9.2, U3.4 (FB)
unnamed: R7.2, U3.3 (PG)
unnamed: C31.1, U3.5 (SS)
unnamed: C22.2, L5.1, U3.7 (SW)
unnamed: C22.1, U3.8 (VBST)
unnamed: C32.1, R7.1, U3.9 (VCC)
unnamed: R10.2, U4.5 (EN)
VBUS: D3.2 (A); also elsewhere on the board
V_{IN}: C23.1, C24.1, C25.1, R4.2, TP5.1 (1_1), U3.1 (VIN); also elsewhere on the board

Notes on the sheet:
2S to 5V Buck Converter
V_{IN} is 2S [6V,8.4V] (7V Nominal)
5V to 3.3V LDO
8.4V * 100k/(100k+100k) = 4.2V 4.2V < 6V EN pin limit

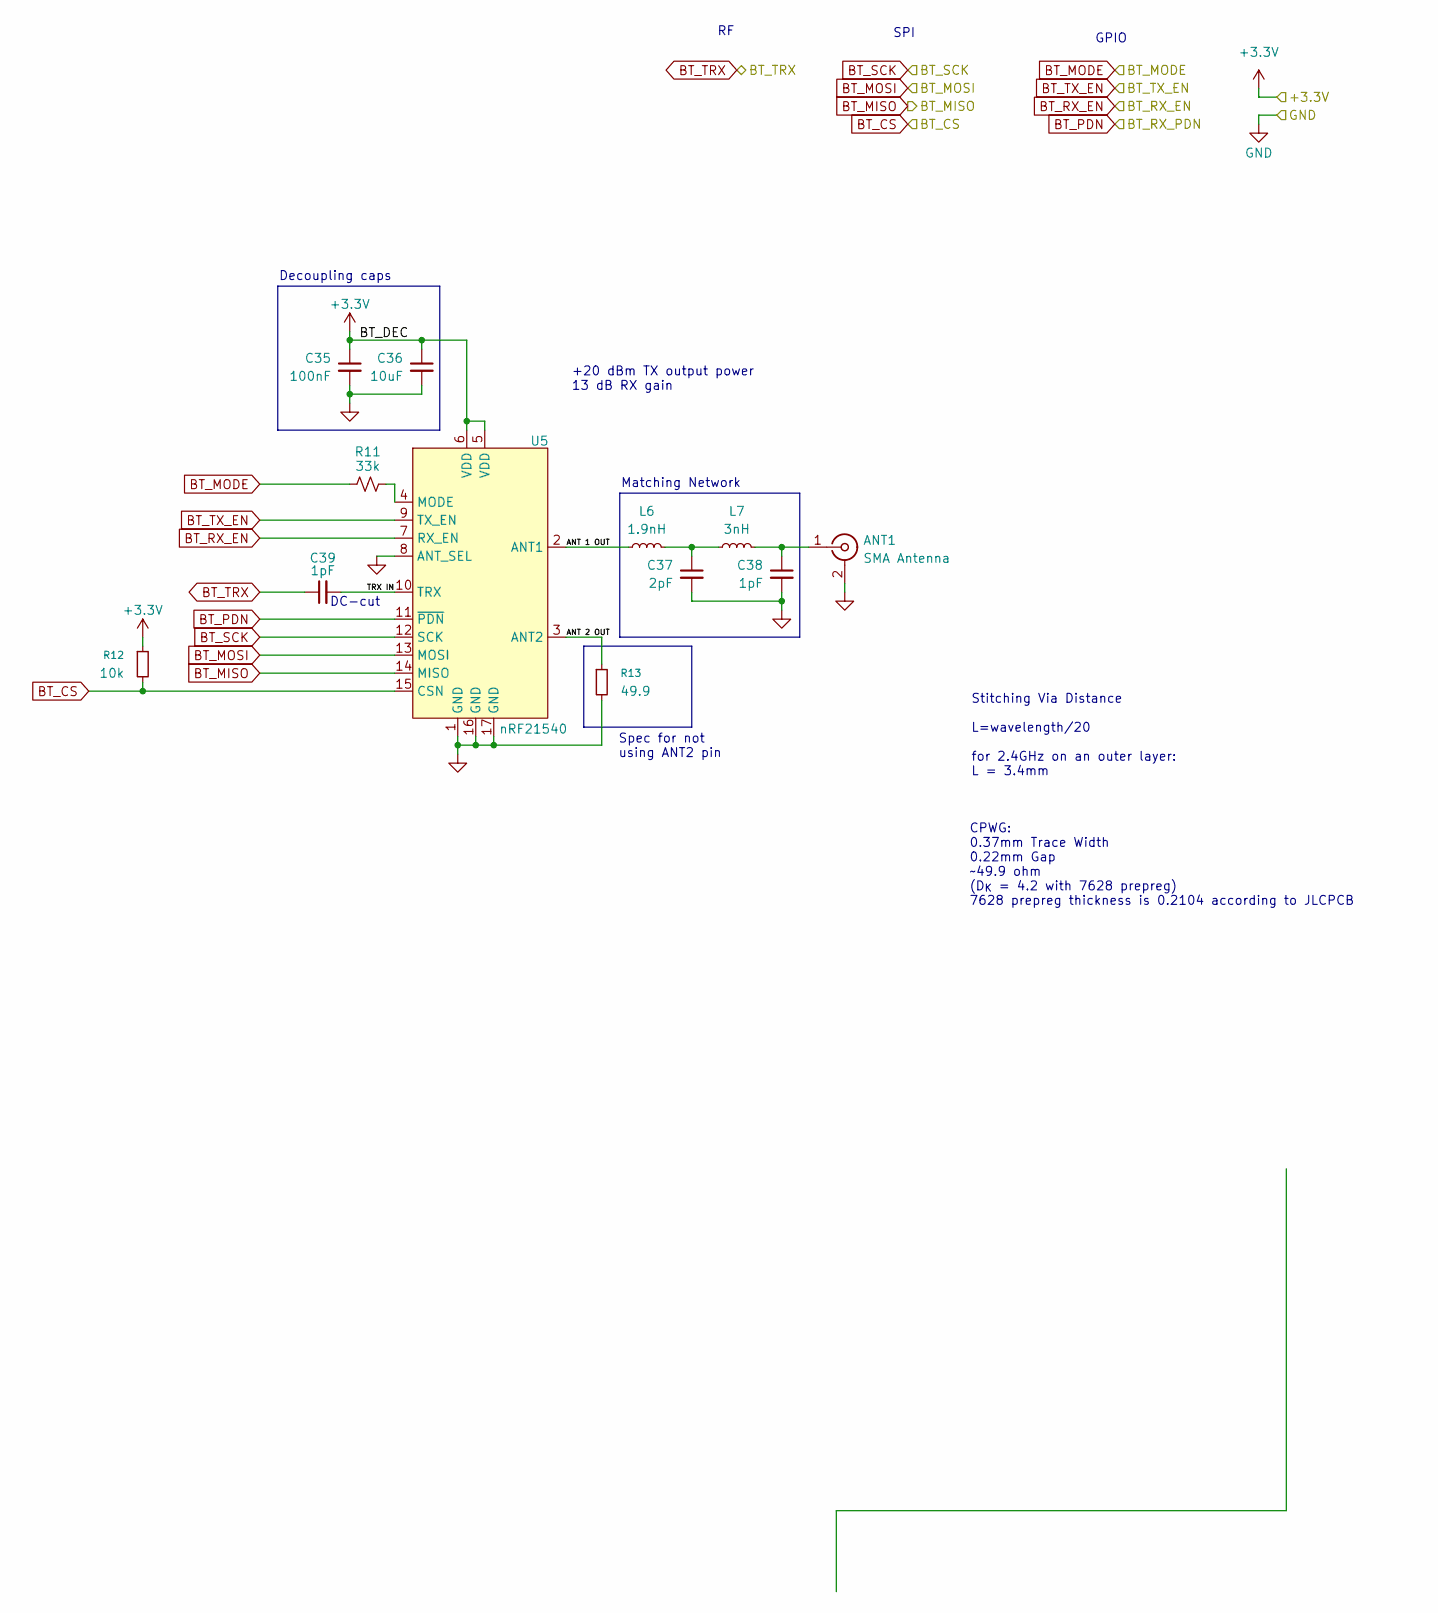
[picture p24: schematic bluetooth.kicad_sch]

Parts:
ANT1: SMA Antenna; SMA_Molex_73251-2120_EdgeMount_Horizontal
C35: 100nF; C_0402_1005Metric
C36: 10uF; C_0603_1608Metric
C37: 2pF; C_0402_1005Metric
C38, C39: 1pF; C_0402_1005Metric
L6: 1.9nH; L_0402_1005Metric
L7: 3nH; L_0402_1005Metric
R11: 33k; R_0603_1608Metric
R12: 10k; R_0603_1608Metric
R13: 49.9; R_0603_1608Metric
U5: nRF21540; QFN-16-1EP_4x4mm_P0.65mm_EP2.7x2.7mm

Connections:
+3.3V: C35.1, C36.1, R12.1, U5.5 (VDD), U5.6 (VDD); also elsewhere on the board
/Bluetooth/ANT 1 OUT: L6.1, U5.2 (ANT1)
/Bluetooth/ANT 2 OUT: R13.1, U5.3 (ANT2)
/Bluetooth/TRX IN: C39.2, U5.10 (TRX)
BT_CS: R12.2, U5.15 (CSN); also elsewhere on the board
BT_MISO: U5.14 (MISO); also elsewhere on the board
BT_MODE: R11.1; also elsewhere on the board
BT_MOSI: U5.13 (MOSI); also elsewhere on the board
BT_PDN: U5.11 (~PDN); also elsewhere on the board
BT_RX_EN: U5.7 (RX_EN); also elsewhere on the board
BT_SCK: U5.12 (SCK); also elsewhere on the board
BT_TX_EN: U5.9 (TX_EN); also elsewhere on the board
GND: ANT1.2 (Ext), C35.2, C36.2, C37.2, C38.2, R13.2, U5.1 (GND), U5.8 (ANT_SEL), U5.16 (GND), U5.17 (GND); also elsewhere on the board
unnamed: ANT1.1 (In), C38.1, L7.2
unnamed: C37.1, L6.2, L7.1
unnamed: R11.2, U5.4 (MODE)
nRF_TRX: C39.1; also elsewhere on the board

Notes on the sheet:
CPWG: 0.37mm Trace Width 0.22mm Gap ~49.9 ohm (D_{K} = 4.2 with 7628 prepreg) 7628 prepreg thickness is 0.2104 according to JLCPCB
SPI
DC-cut
+20 dBm TX output power 13 dB RX gain
Spec for not using ANT2 pin
Matching Network
Stitching Via Distance L=wavelength/20 for 2.4GHz on an outer layer: L = 3.4mm
GPIO
Decoupling caps

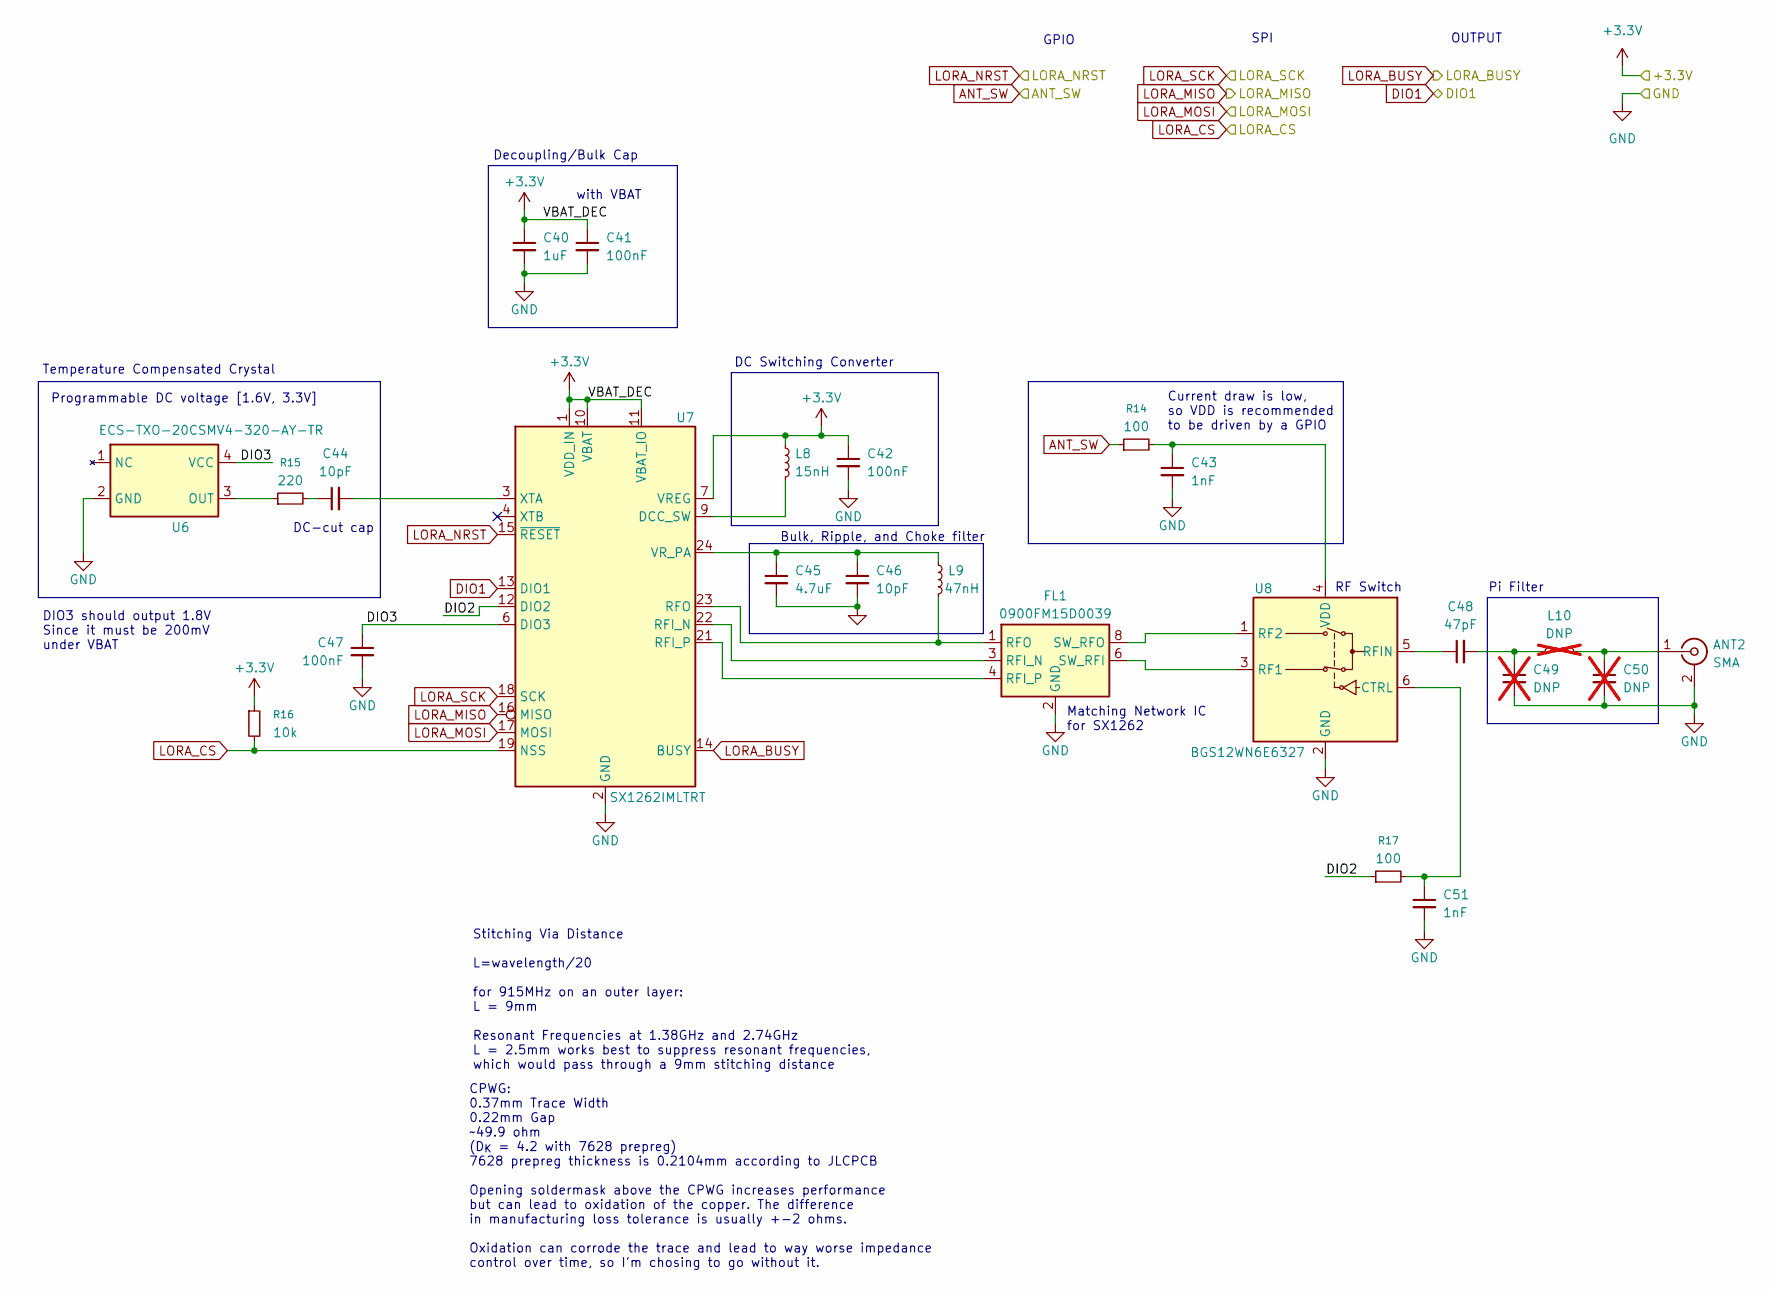
[picture p25: schematic lora.kicad_sch, 915MHz LoRa Modem]

Parts:
ANT2: SMA; SMA_Molex_73251-2120_EdgeMount_Horizontal
C40: 1uF; C_0603_1608Metric
C41, C42, C47: 100nF; C_0402_1005Metric
C43, C51: 1nF; C_0402_1005Metric
C44, C46: 10pF; C_0402_1005Metric
C45: 4.7uF; C_0603_1608Metric
C48: 47pF; C_0402_1005Metric
C49, C50: DNP; C_0402_1005Metric; not fitted
FL1: 0900FM15D0039; Balun_Johanson_0900FM15K0039
L8: 15nH; L_0402_1005Metric
L9: 47nH; L_0402_1005Metric
L10: DNP; L_0402_1005Metric; not fitted
R14, R17: 100; R_0603_1608Metric
R15: 220; R_0603_1608Metric
R16: 10k; R_0603_1608Metric
U6: ECS-TXO-20CSMV4-320-AY-TR; Oscillator_SMD_ECS_2016
U7: SX1262IMLTRT; QFN-24-1EP_4x4mm_P0.5mm_EP2.6x2.6mm
U8: BGS12WN6E6327; Infineon_PG-TSNP-6-10_0.7x1.1mm_0.7x1.1mm_P0.4mm

Connections:
+3.3V: C40.1, C41.1, C42.1, L8.1, R16.1, U7.1 (VDD_IN), U7.7 (VREG), U7.10 (VBAT), U7.11 (VBAT_IO); also elsewhere on the board
/LoRa/DIO2: R17.1, U7.12 (DIO2)
/LoRa/DIO3: C47.1, U6.4 (VCC), U7.6 (DIO3)
ANT_SW: R14.1; also elsewhere on the board
DIO1: U7.13 (DIO1); also elsewhere on the board
GND: ANT2.2 (Ext), C40.2, C41.2, C42.2, C43.2, C45.2, C46.2, C47.2, C49.2, C50.2, C51.2, FL1.2 (GND), FL1.5 (GND), FL1.7 (GND), FL1.9 (GND), FL1.10 (GND), U6.2 (GND), U7.2 (GND), U7.5 (GND), U7.8 (GND), U7.20 (GND), U7.25 (GND), U8.2 (GND); also elsewhere on the board
LORA_BUSY: U7.14 (BUSY); also elsewhere on the board
LORA_CS: R16.2, U7.19 (NSS); also elsewhere on the board
LORA_MISO: U7.16 (MISO); also elsewhere on the board
LORA_MOSI: U7.17 (MOSI); also elsewhere on the board
LORA_NRST: U7.15 (~RESET); also elsewhere on the board
LORA_SCK: U7.18 (SCK); also elsewhere on the board
unnamed: ANT2.1 (In), C50.1, L10.2
unnamed: C44.1, R15.2
unnamed: C48.2, C49.1, L10.1
unnamed: FL1.3 (RFI_N), U7.22 (RFI_N)
unnamed: FL1.4 (RFI_P), U7.21 (RFI_P)
unnamed: FL1.1 (RFO), L9.2, U7.23 (RFO)
unnamed: FL1.6 (SW_RFI), U8.3 (RF1)
unnamed: FL1.8 (SW_RFO), U8.1 (RF2)
unnamed: R15.1, U6.3 (OUT)
unnamed: L8.2, U7.9 (DCC_SW)
unnamed: C45.1, C46.1, L9.1, U7.24 (VR_PA)
unnamed: C44.2, U7.3 (XTA)
unnamed: C51.1, R17.2, U8.6 (CTRL)
unnamed: C48.1, U8.5 (RFIN)
unnamed: C43.1, R14.2, U8.4 (VDD)

Notes on the sheet:
Matching Network IC for SX1262
DC-cut cap
Pi Filter
DIO3 should output 1.8V Since it must be 200mV under VBAT
Temperature Compensated Crystal
Current draw is low, so VDD is recommended to be driven by a GPIO
GPIO
RF Switch
Stitching Via Distance L=wavelength/20 for 915MHz on an outer layer: L = 9mm Resonant Frequencies at 1.38GHz and 2.74GHz L = 2.5mm works best to suppress resonant frequencies, which would pass through a 9mm stitching distance
OUTPUT
Decoupling/Bulk Cap
with VBAT
DC Switching Converter
SPI
Bulk, Ripple, and Choke filter
CPWG: 0.37mm Trace Width 0.22mm Gap ~49.9 ohm (D_{K} = 4.2 with 7628 prepreg) 7628 prepreg thickness is 0.2104mm according to JLCPCB Opening soldermask above the CPWG increases performance but can lead to oxidation of the copper. The difference in manufacturing loss tolerance is usually +-2 ohms. O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
Programmable DC voltage [1.6V, 3.3V]

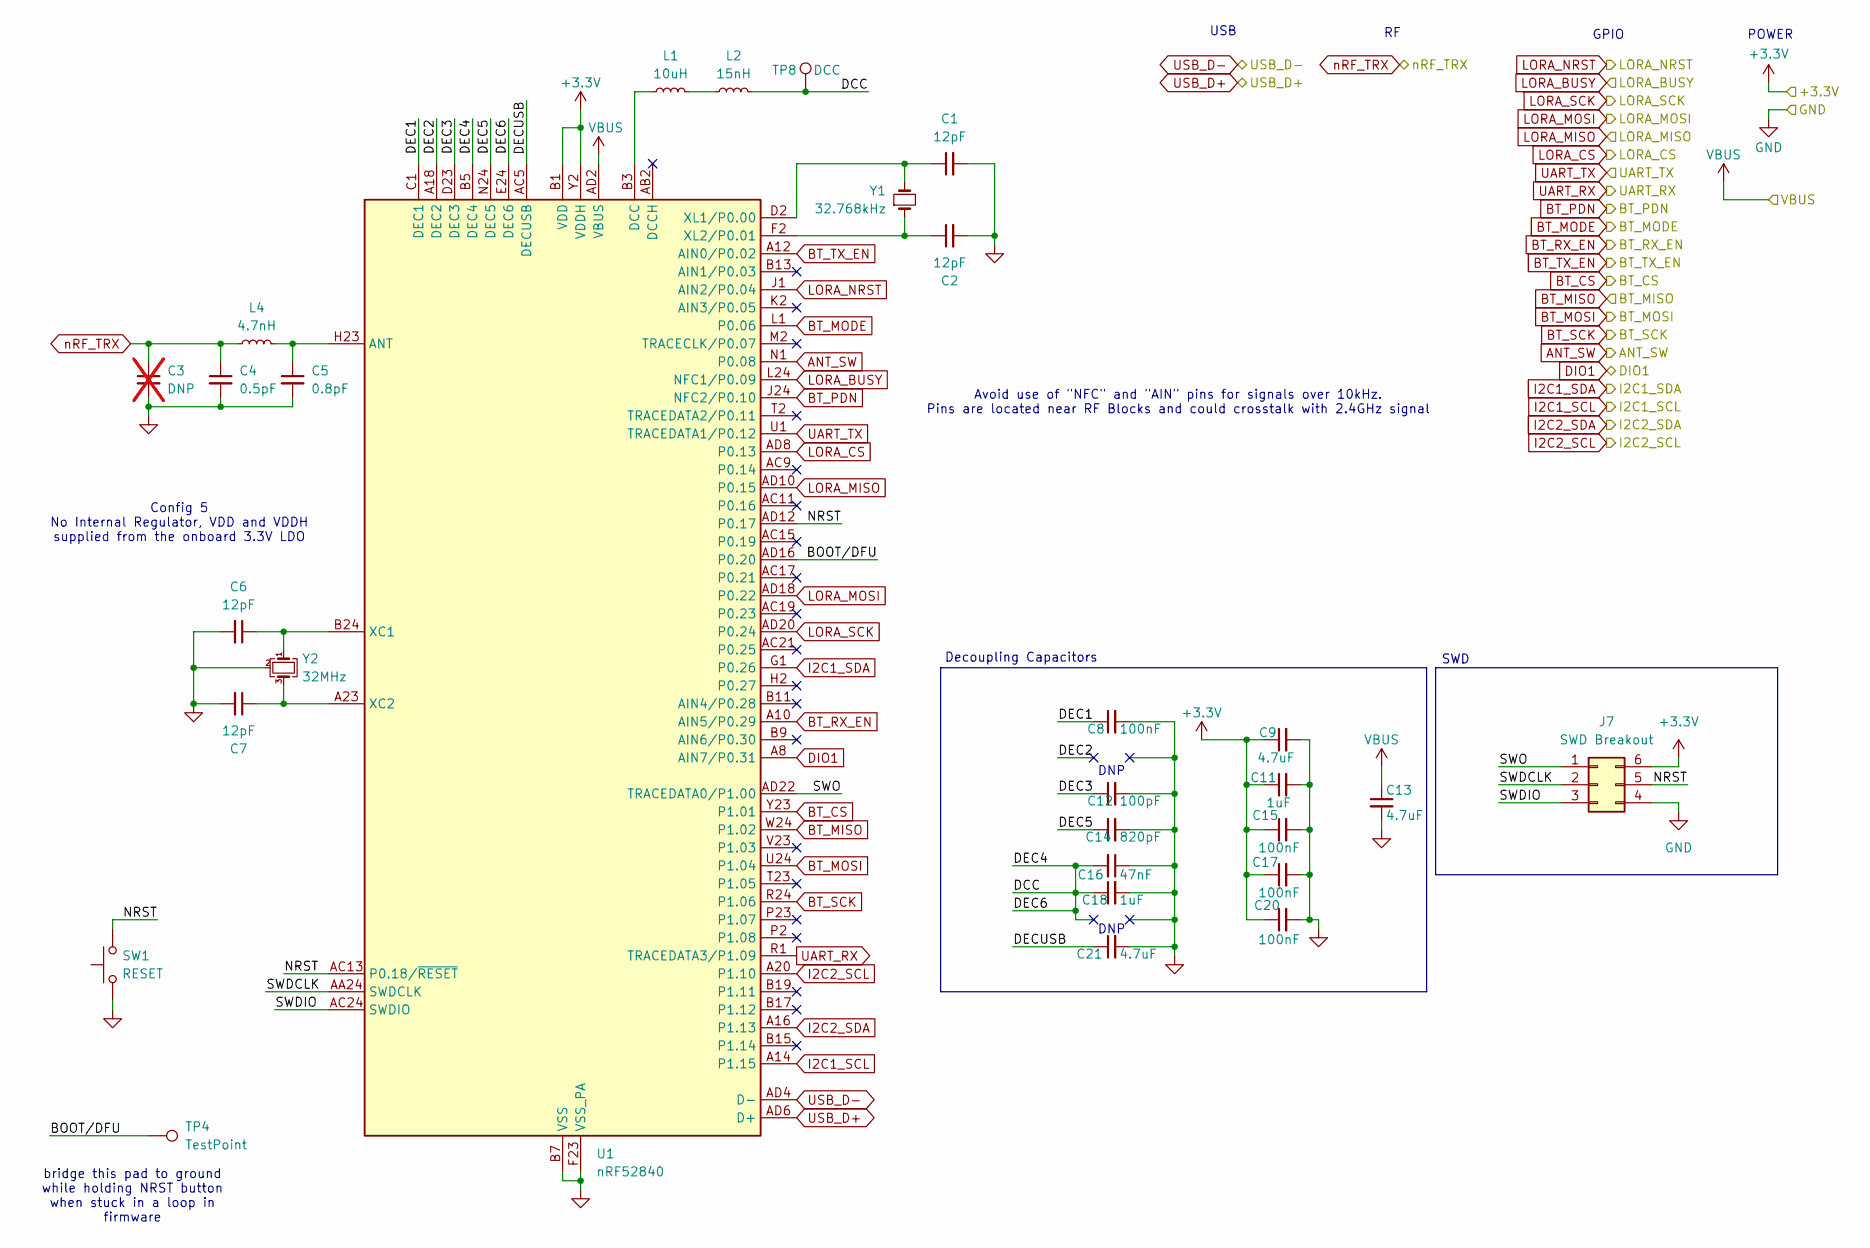
[picture p26: schematic MCU.kicad_sch, nRF52840 Interface MCU]

Parts:
C1, C2, C6, C7: 12pF; C_0402_1005Metric; LCSC Part Number C1547
C3: DNP; C_0402_1005Metric; not fitted
C4: 0.5pF; C_0402_1005Metric; LCSC Part Number C1544
C5: 0.8pF; C_0402_1005Metric; LCSC Part Number C88902
C8, C15, C17, C20: 100nF; C_0402_1005Metric; LCSC Part Number C1525
C9, C13, C21: 4.7uF; C_0603_1608Metric; LCSC Part Number C1779
C11, C18: 1uF; C_0603_1608Metric; LCSC Part Number C15849
C12: 100pF; C_0402_1005Metric; LCSC Part Number C1546
C14: 820pF; C_0402_1005Metric; LCSC Part Number C1543
C16: 47nF; C_0402_1005Metric; LCSC Part Number C82219
J7: SWD Breakout; PinHeader_2x03_P2.54mm_Vertical
L1: 10uH; L_0603_1608Metric; LCSC Part Number C1035
L2: 15nH; L_0402_1005Metric; LCSC Part Number C86059
L4: 4.7nH; L_0402_1005Metric; LCSC Part Number C86065
SW1: RESET; SW_Push_SPST_NO_Alps_SKRK; LCSC Part Number C720477
TP4: TestPoint; TestPoint_Pad_D1.0mm
TP8: DCC; TestPoint_Pad_D1.0mm
U1: nRF52840; Nordic_AQFN-73-1EP_7x7mm_P0.5mm
Y1: 32.768kHz; Crystal_SMD_3215-2Pin_3.2x1.5mm; LCSC Part Number C32346
Y2: 32MHz; Crystal_SMD_3225-4Pin_3.2x2.5mm; LCSC Part Number C9009

Connections:
+3.3V: C9.1, C11.1, C15.1, C17.1, C20.1, J7.6, U1.A22 (VDD), U1.AD14 (VDD), U1.AD23 (VDD), U1.B1 (VDD), U1.W1 (VDD), U1.Y2 (VDDH); also elsewhere on the board
/MCU/BOOT/DFU: TP4.1 (1_1), U1.AD16 (P0.20)
/MCU/DCC: C16.2, C18.1, L2.2, TP8.1 (1_1), U1.B5 (DEC4), U1.E24 (DEC6)
/MCU/DEC1: C8.1, U1.C1 (DEC1)
/MCU/DEC2: U1.A18 (DEC2)
/MCU/DEC3: C12.1, U1.D23 (DEC3)
/MCU/DEC5: C14.1, U1.N24 (DEC5)
/MCU/DECUSB: C21.1, U1.AC5 (DECUSB)
/MCU/NRST: J7.5, SW1.2, U1.AC13 (P0.18/~RESET), U1.AD12 (P0.17)
/MCU/SWDCLK: J7.2, U1.AA24 (SWDCLK)
/MCU/SWDIO: J7.3, U1.AC24 (SWDIO)
/MCU/SWO: J7.1, U1.AD22 (TRACEDATA0/P1.00)
ANT_SW: U1.N1 (P0.08); also elsewhere on the board
BT_CS: U1.Y23 (P1.01); also elsewhere on the board
BT_MISO: U1.W24 (P1.02); also elsewhere on the board
BT_MODE: U1.L1 (P0.06); also elsewhere on the board
BT_MOSI: U1.U24 (P1.04); also elsewhere on the board
BT_PDN: U1.J24 (NFC2/P0.10); also elsewhere on the board
BT_RX_EN: U1.A10 (AIN5/P0.29); also elsewhere on the board
BT_SCK: U1.R24 (P1.06); also elsewhere on the board
BT_TX_EN: U1.A12 (AIN0/P0.02); also elsewhere on the board
DIO1: U1.A8 (AIN7/P0.31); also elsewhere on the board
GND: C1.2, C2.2, C3.2, C4.2, C5.2, C6.2, C7.2, C8.2, C9.2, C11.2, C12.2, C13.2, C14.2, C15.2, C16.1, C17.2, C18.2, C20.2, C21.2, J7.4, SW1.1, U1.B7 (VSS), U1.EP (VSS), U1.F23 (VSS_PA), Y2.2 (G), Y2.4 (G); also elsewhere on the board
I2C1_SCL: U1.A14 (P1.15); also elsewhere on the board
I2C1_SDA: U1.G1 (P0.26); also elsewhere on the board
I2C2_SCL: U1.A20 (P1.10); also elsewhere on the board
I2C2_SDA: U1.A16 (P1.13); also elsewhere on the board
LORA_BUSY: U1.L24 (NFC1/P0.09); also elsewhere on the board
LORA_CS: U1.AD8 (P0.13); also elsewhere on the board
LORA_MISO: U1.AD10 (P0.15); also elsewhere on the board
LORA_MOSI: U1.AD18 (P0.22); also elsewhere on the board
LORA_NRST: U1.J1 (AIN2/P0.04); also elsewhere on the board
LORA_SCK: U1.AD20 (P0.24); also elsewhere on the board
unnamed: L1.2, L2.1
unnamed: C5.1, L4.2, U1.H23 (ANT)
unnamed: L1.1, U1.B3 (DCC)
unnamed: C6.1, U1.B24 (XC1), Y2.1
unnamed: C7.1, U1.A23 (XC2), Y2.3
unnamed: C1.1, U1.D2 (XL1/P0.00), Y1.2
unnamed: C2.1, U1.F2 (XL2/P0.01), Y1.1
UART_RX: U1.R1 (TRACEDATA3/P1.09); also elsewhere on the board
UART_TX: U1.U1 (TRACEDATA1/P0.12); also elsewhere on the board
USB_D+: U1.AD6 (D+); also elsewhere on the board
USB_D-: U1.AD4 (D-); also elsewhere on the board
VBUS: C13.1, U1.AD2 (VBUS); also elsewhere on the board
nRF_TRX: C3.1, C4.1, L4.1; also elsewhere on the board

Notes on the sheet:
POWER
SWD
DNP
GPIO
bridge this pad to ground while holding NRST button when stuck in a loop in firmware
Decoupling Capacitors
Avoid use of "NFC" and "AIN" pins for signals over 10kHz. Pins are located near RF Blocks and could crosstalk with 2.4GHz signal
Config 5 No Internal Regulator, VDD and VDDH supplied from the onboard 3.3V LDO
USB

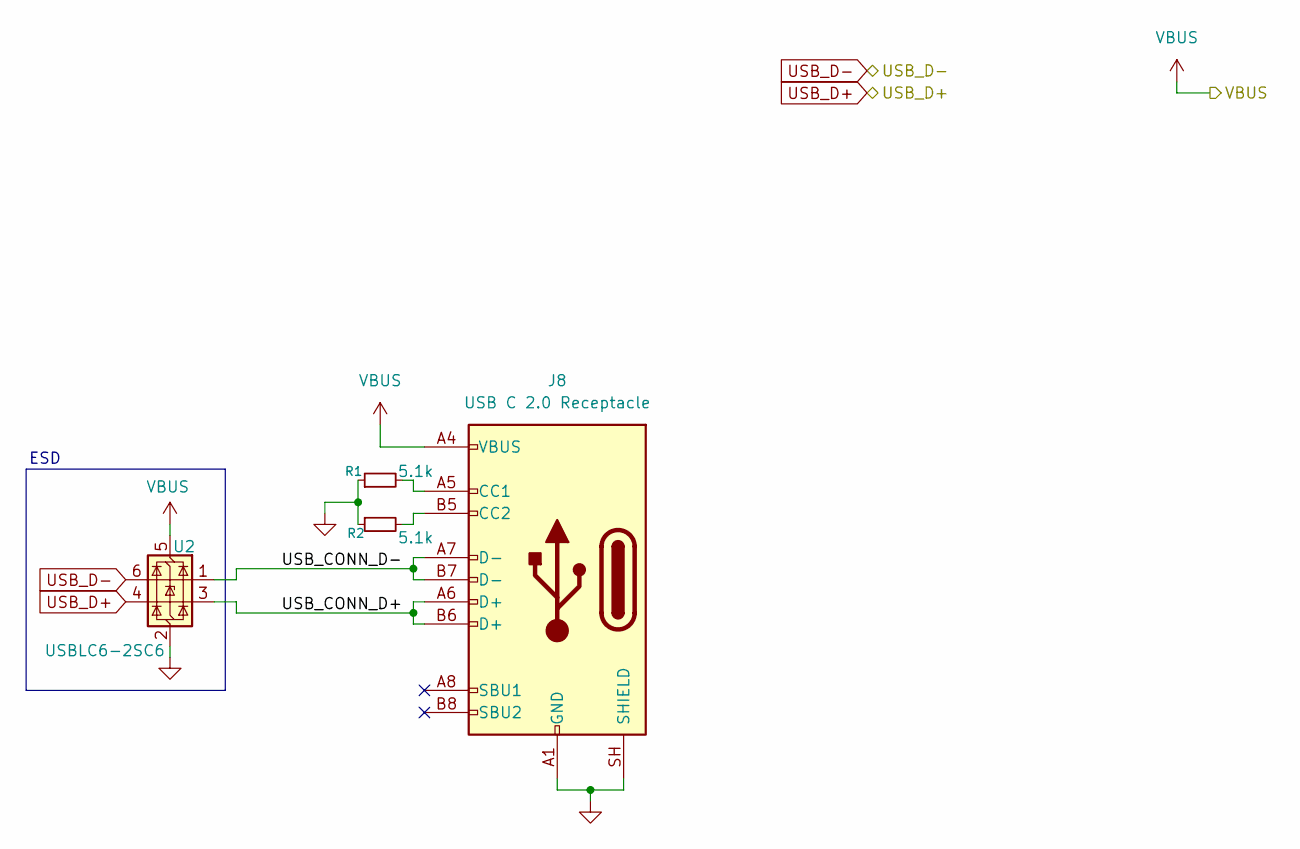
[picture p27: schematic USB.kicad_sch, USB-C 2.0 and ESD]

Parts:
J8: USB C 2.0 Receptacle; USB_C_Receptacle_HRO_TYPE-C-31-M-12
R1, R2: 5.1k; R_0603_1608Metric
U2: USBLC6-2SC6; SOT-23-6

Connections:
/USB/USB_CONN_D+: J8.A6 (D+), J8.B6 (D+), U2.3 (I/O2)
/USB/USB_CONN_D-: J8.A7 (D-), J8.B7 (D-), U2.1 (I/O1)
GND: J8.A1 (GND), J8.A12 (GND), J8.B1 (GND), J8.B12 (GND), J8.SH (SHIELD), R1.1, R2.1, U2.2 (GND); also elsewhere on the board
unnamed: J8.A5 (CC1), R1.2
unnamed: J8.B5 (CC2), R2.2
USB_D+: U2.4 (I/O2); also elsewhere on the board
USB_D-: U2.6 (I/O1); also elsewhere on the board
VBUS: J8.A4 (VBUS), J8.A9 (VBUS), J8.B4 (VBUS), J8.B9 (VBUS), U2.5 (VBUS); also elsewhere on the board

Notes on the sheet:
ESD

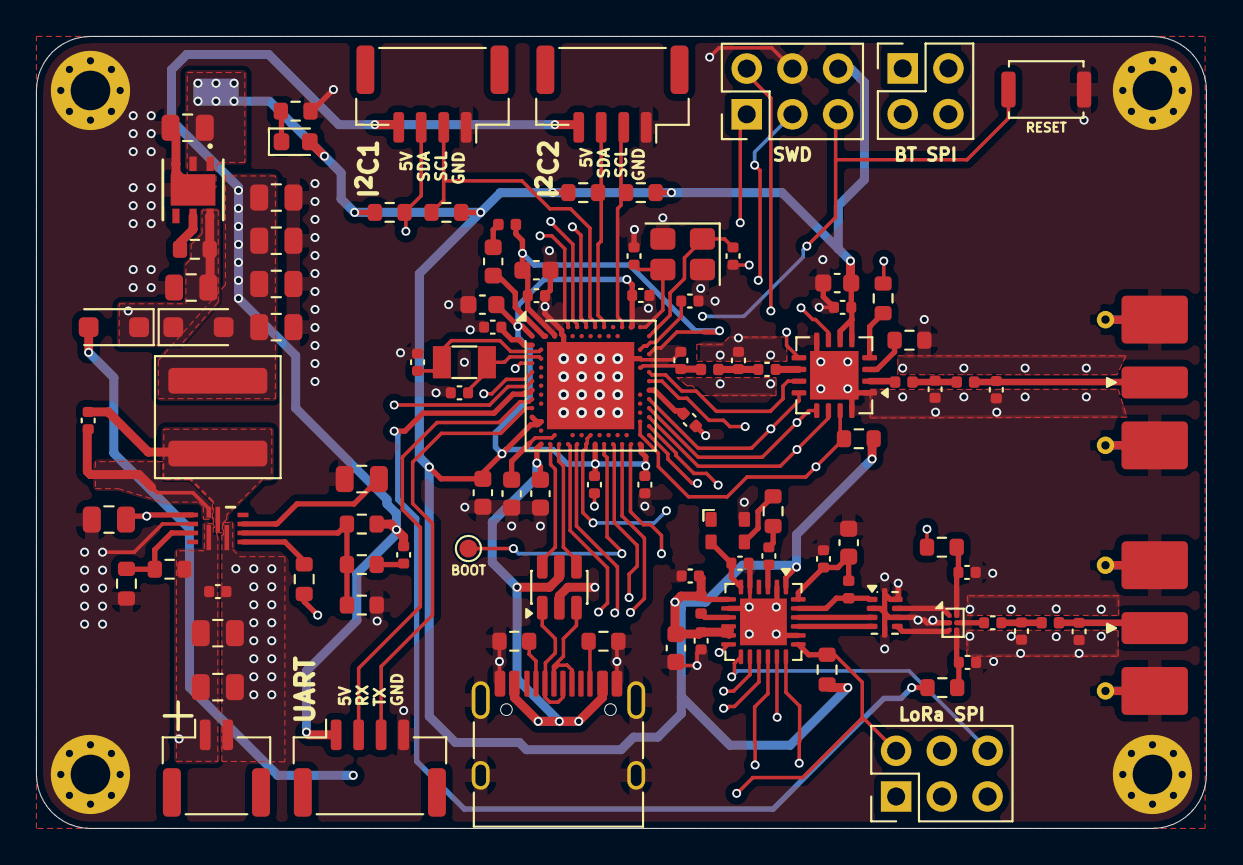
[picture p28: board pcb.kicad_pcb from above]

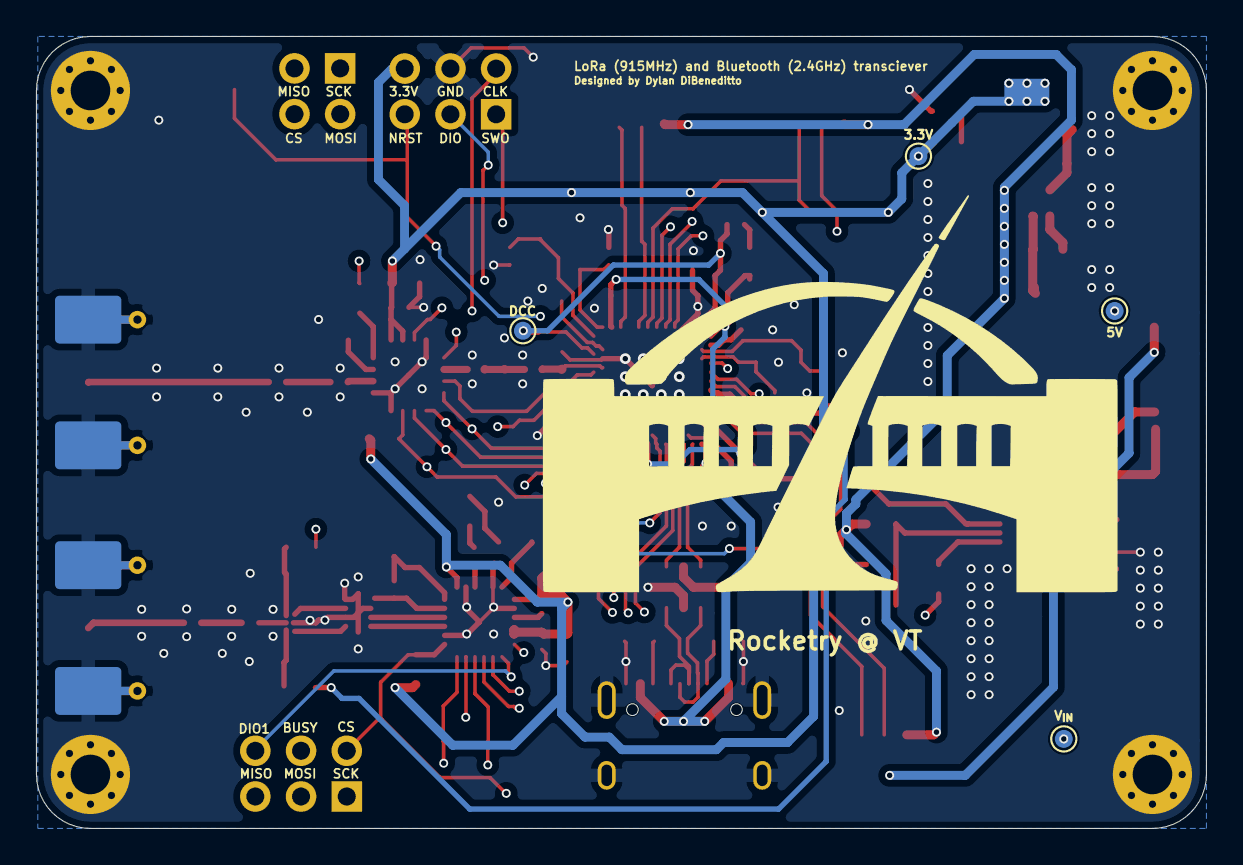
[picture p29: board pcb.kicad_pcb from below]

Board: 4 copper layers, 65.0 x 44.0 mm, 112 parts (4 on the bottom side), 85 nets.
