dylandibeneditto/bt-lora-transciever/(commit log)

2026-10-15 buck converter and updates
2026-10-16 switch TCXO, laid out from ref design from nordic
